AWQUA/improved-handheld-turbidimeter/version_A/hardware/stencil_files/main_board_v2.pdf

main_board_v2 (Visible layers) Scale=1.00 Wed Jul 12 17:47:27 2017

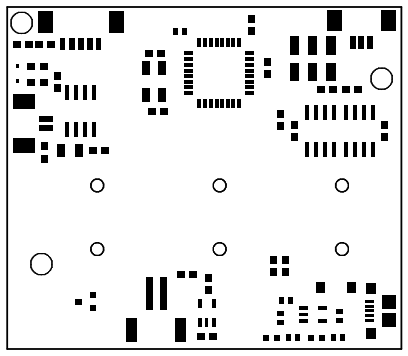
[picture p1: figure]
