AWQUA/improved-handheld-turbidimeter/version_A/testing/iht_A_dual_led_temperature_adjustment_20170707.xlsx

Sheet: Sheet1
0 | 5 | 8005.8 | 62.55
0 | 5 | 8005.11 | 62.54
0 | 5 | 8004.82 | 62.54
0 | 5 | 8005.34 | 62.54
0 | 5 | 8005.04 | 62.54
0 | 5 | 8004.91 | 62.54 |  | f | 5562.984315
0 | 5 | 8005.07 | 62.54
0 | 5 | 8004.42 | 62.54
0 | 5 | 8004.34 | 62.54 |  | Cp | 7.2e-10
0 | 5 | 8004.82 | 62.54 |  | GBW | 14000
0 | 5 | 8004.01 | 62.53 |  | Rl | 100000
0 | 5 | 8004.3 | 62.54
0 | 5 | 8004.87 | 62.54
0 | 5 | 8005.09 | 62.54
0.00 | 5 | 8005.16 | 62.54 |  |  |  |  |  | 20479.375
0.00 | 5 | 8004.77 | 62.54
0.00 | 5 | 8005.56 | 62.55
0.00 | 5 | 8005.59 | 62.55 |  | 0.256 | 7.812738426e-06 | 0.007812738426 | 251.1795404 | 320 | 68.82045961
0.00 | 5 | 8005.53 | 62.55 |  | 0.512 | 1.562547685e-05 | 0.01562547685
0.00 | 5 | 8006.06 | 62.55 |  | 1.024 | 3.12509537e-05 | 0.0312509537
0.00 | 5 | 8005.99 | 62.55 |  | 2.048 | 6.250190741e-05 | 0.06250190741
0.00 | 5 | 8005.75 | 62.55 |  | 4.096 | 0.0001250038148 | 0.1250038148
 |  |  |  |  | 6.144 | 0.0001875057222 | 0.1875057222
 |  |  |  | 1024 | 0 | 2152 | 67.25205237 | 54
 |  |  |  |  | 10 | 3446 | 107.6907865 | 80 | 129.4
 |  |  |  |  | 20 | 5162 | 161.317423 | 106 | 171.6
 |  |  |  |  | 30 | 7040 | 220.0067141 | 136 | 187.8
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
