AWQUA/improved-handheld-turbidimeter/version_A/hardware/images/hardware_flowchart.pdf

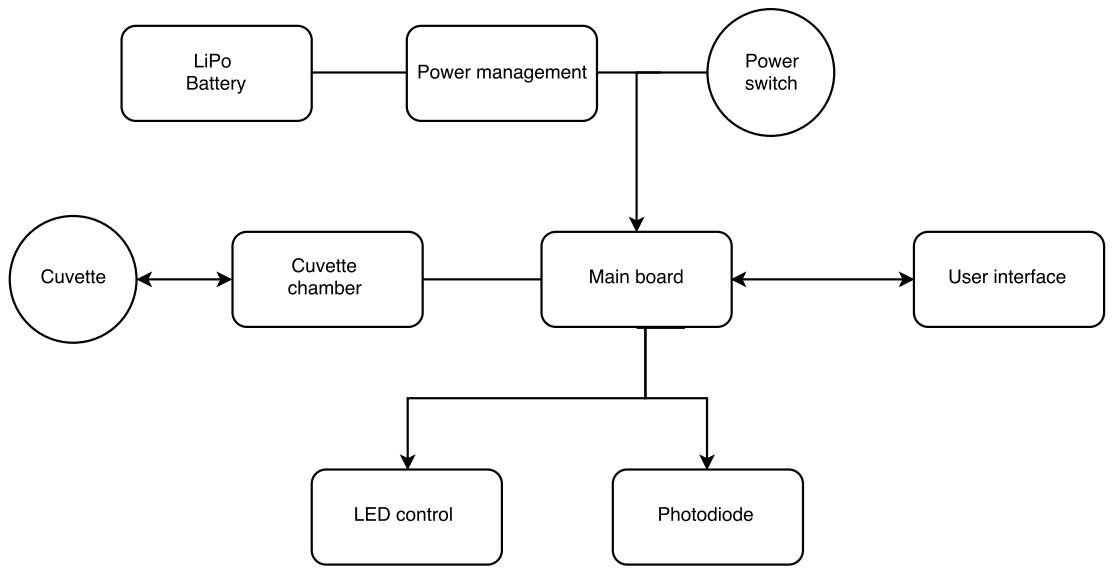
[picture p2: page 1]
