AWQUA/improved-handheld-turbidimeter/version_C/hardware/max30105.brd

## EAGLE design version_C/hardware/max30105.brd (2018-06-20)

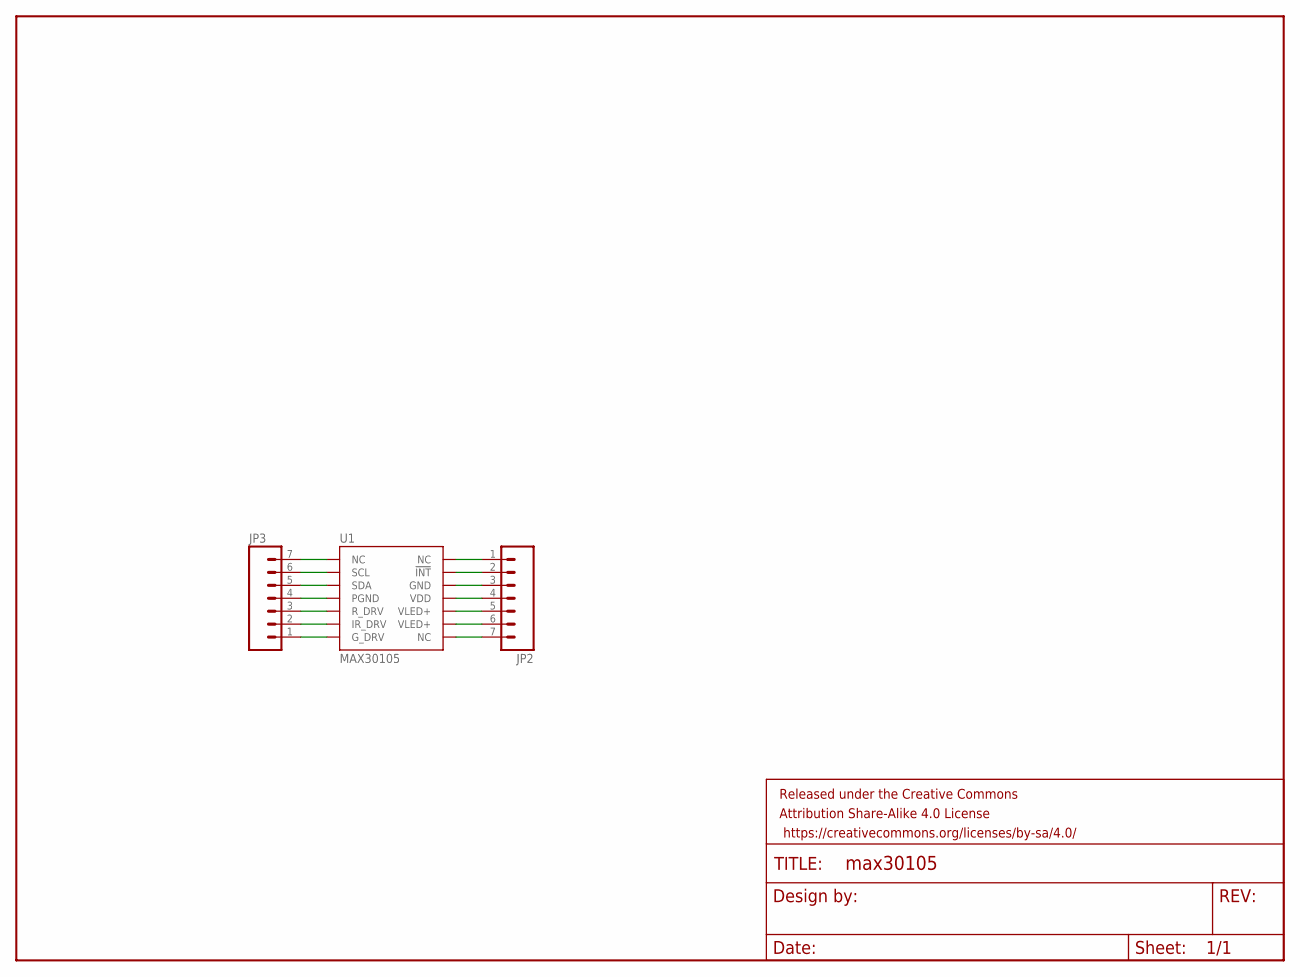
[picture p3: schematic max30105.sch]

Parts:
FRAME1: FRAME-LETTER; CREATIVE_COMMONS
JP2, JP3: M07; 1X07
U1: MAX30105; OLGA-14

Connections:
unnamed: JP2.1, U1.14 (NC)
unnamed: JP2.2, U1.13 (!INT)
unnamed: JP2.3, U1.12 (GND)
unnamed: JP2.4, U1.11 (VDD)
unnamed: JP2.5, U1.10 (VLED+)
unnamed: JP2.6, U1.9 (VLED+)
unnamed: JP2.7, U1.8 (NC)
unnamed: JP3.1, U1.7 (G_DRV)
unnamed: JP3.2, U1.6 (IR_DRV)
unnamed: JP3.3, U1.5 (R_DRV)
unnamed: JP3.4, U1.4 (PGND)
unnamed: JP3.5, U1.3 (SDA)
unnamed: JP3.6, U1.2 (SCL)
unnamed: JP3.7, U1.1 (NC)

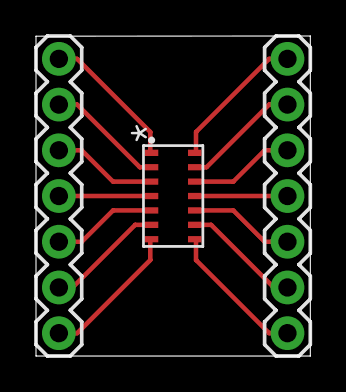
[picture p4: board max30105.brd from above]

Board: 2 copper layers, 15.2 x 17.8 mm, 4 parts (0 on the bottom side), 14 nets.
