AWQUA/improved-handheld-turbidimeter/version_C/hardware/max30105_breakout_iiT.brd

## EAGLE design version_C/hardware/max30105_breakout_iiT.brd (2018-06-20)

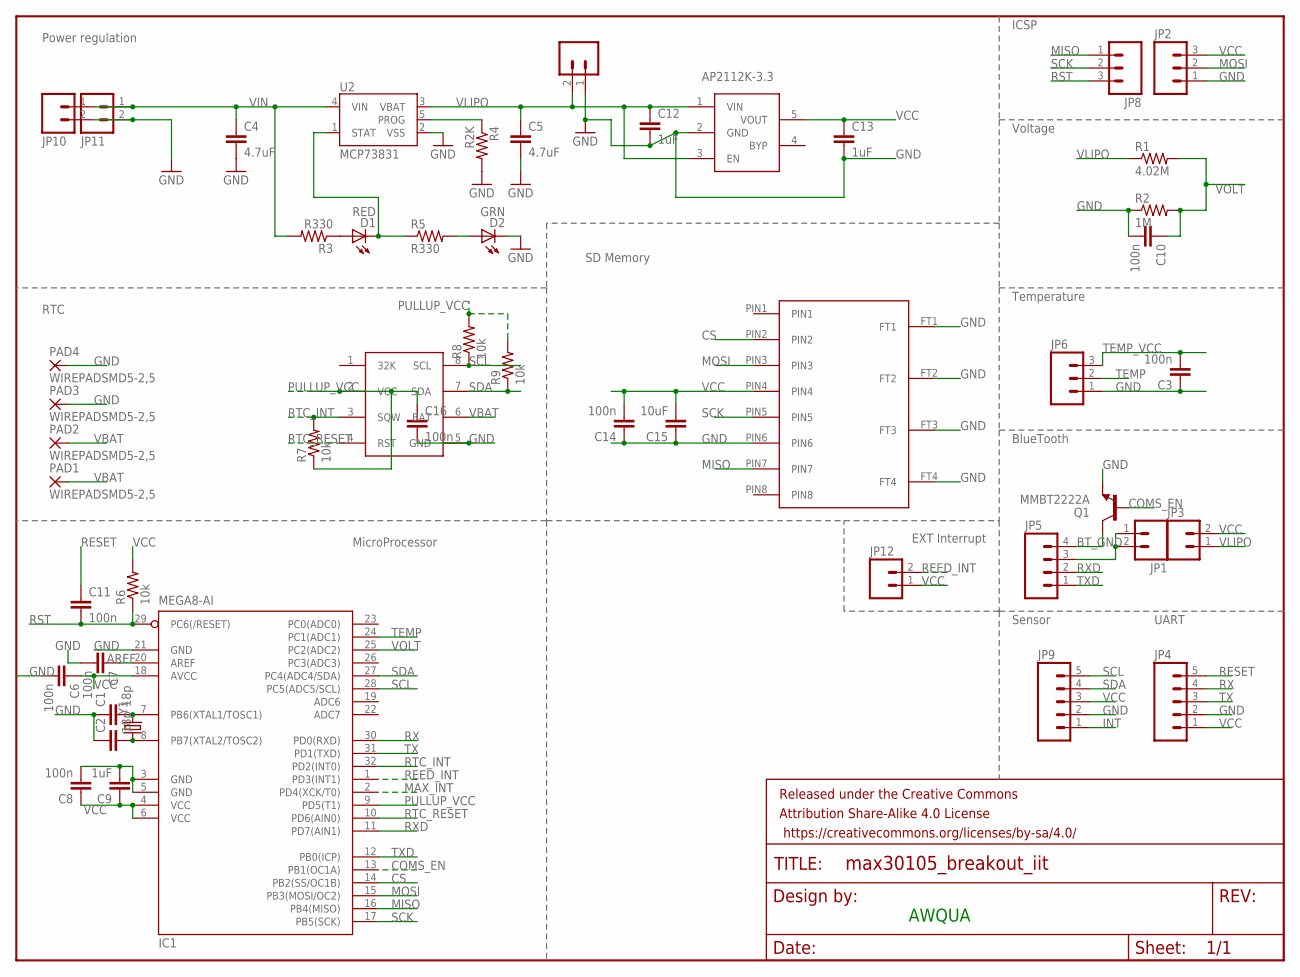
[picture p5: schematic max30105_breakout_iiT.sch]

Parts:
*RTC: DS3231M
C1, C2: 18p; 0603-CAP
C3, C6, C7, C8, C10, C11, C14, C16: 100n; 0603-CAP
C4, C5: 4.7uF; 0603-CAP
C9, C12, C13: 1uF; 0603-CAP
C15: 10uF; 0603-CAP
D1: RED; LED-0603
D2: GRN; LED-0603
FRAME1: FRAME-LETTER; CREATIVE_COMMONS
IC1: MEGA8-AI; TQFP32-08
JP1, JP3, JP10, JP11, JP12: M02PTH; 1X02
JP2, JP6, JP8: M03PTH; 1X03
JP4, JP9: M05PTH; 1X05
JP5: M04PTH; 1X04
JP7: LiPo Battery; JST-2-SMD
MICRO-SD: MICROSD-1010030368
PAD1, PAD2, PAD3, PAD4: WIREPADSMD5-2,5; 5-2,5
Q1: MMBT2222A; SOT23-3
R1: 4.02M; 0603-RES
R2: 1M; 0603-RES
R3, R5: R330; 0603-RES
R4: R2K; 0603-RES
R6, R7, R8, R9: 10k; 0603-RES
U2: MCP73831; SOT23-5
U$6: AP2112K-3.3; LP2985
Y1: CRYSTAL5X3; CRYSTAL-SMD-5X3

Connections:
AREF: C7.1, IC1.20 (AREF)
BT_GND: JP5.4, Q1.3 (C)
COMS_EN: IC1.13 (PB1(OC1A)), Q1.1 (B)
CS: IC1.14 (PB2(SS/OC1B)), MICRO-SD.PIN2
GND: *RTC.5 (GND), C1.1, C2.1, C3.1, C4.2, C5.2, C6.2, C7.2, C8.2, C9.2, C10.2, C12.2, C13.2, C14.1, C15.1, C16.2, D2.C, IC1.3 (GND), IC1.5 (GND), IC1.21 (GND), JP2.1, JP4.2, JP6.1, JP7.1, JP9.2, JP10.2, JP11.2, MICRO-SD.FT1, MICRO-SD.FT2, MICRO-SD.FT3, MICRO-SD.FT4, MICRO-SD.PIN6, PAD3.1, PAD4.1, Q1.2 (E), R2.1, R4.2, U2.2 (VSS), U$6.2 (GND)
INT: JP9.1
MAX_INT: IC1.2 (PD4(XCK/T0))
MISO: IC1.16 (PB4(MISO)), JP8.1, MICRO-SD.PIN7
MOSI: IC1.15 (PB3(MOSI/OC2)), JP2.2, MICRO-SD.PIN3
unnamed: D1.A, R3.1
unnamed: JP1.1, JP1.2, JP5.3
unnamed: D2.A, R5.2
PROG: R4.1, U2.5 (PROG)
PULLUP_VCC: *RTC.2 (VCC), C16.1, IC1.9 (PD5(T1)), R7.1, R8.2, R9.2
Q1: C2.2, IC1.8 (PB7(XTAL2/TOSC2)), Y1.1
Q2: C1.2, IC1.7 (PB6(XTAL1/TOSC1)), Y1.3 (2)
REED_INT: IC1.1 (PD3(INT1)), JP12.2
RESET: C11.1, JP4.5
RST: C11.2, IC1.29 (PC6(/RESET)), JP8.3, R6.1
RTC_INT: *RTC.3 (SQW), IC1.32 (PD2(INT0)), R7.2
RTC_RESET: *RTC.4 (RST), IC1.10 (PD6(AIN0))
RX: IC1.30 (PD0(RXD)), JP4.4
RXD: IC1.11 (PD7(AIN1)), JP5.2
SCK: IC1.17 (PB5(SCK)), JP8.2, MICRO-SD.PIN5
SCL: *RTC.8 (SCL), IC1.28 (PC5(ADC5/SCL)), JP9.5, R8.1
SDA: *RTC.7 (SDA), IC1.27 (PC4(ADC4/SDA)), JP9.4, R9.1
STAT: D1.C, R5.1, U2.1 (STAT)
TEMP: IC1.24 (PC1(ADC1)), JP6.2
TEMP_VCC: C3.2, JP6.3
TX: IC1.31 (PD1(TXD)), JP4.3
TXD: IC1.12 (PB0(ICP)), JP5.1
VBAT: *RTC.6 (BAT), PAD1.1, PAD2.1
VCC: C6.1, C8.1, C9.1, C13.1, C14.2, C15.2, IC1.4 (VCC), IC1.6 (VCC), IC1.18 (AVCC), JP2.3, JP3.2, JP4.1, JP9.3, JP12.1, MICRO-SD.PIN4, R6.2, U$6.5 (VOUT)
VIN: C4.1, JP10.1, JP11.1, R3.2, U2.4 (VIN)
VLIPO: C5.1, C12.1, JP3.1, JP7.2, R1.1, U2.3 (VBAT), U$6.1 (VIN), U$6.3 (EN)
VOLT: C10.1, IC1.25 (PC2(ADC2)), R1.2, R2.2

Notes on the sheet:
AWQUA
Temperature
UART
ICSP
Voltage
BlueTooth
Sensor
Power regulation
AP2112K-3.3
SD Memory
RTC
MicroProcessor
EXT Interrupt

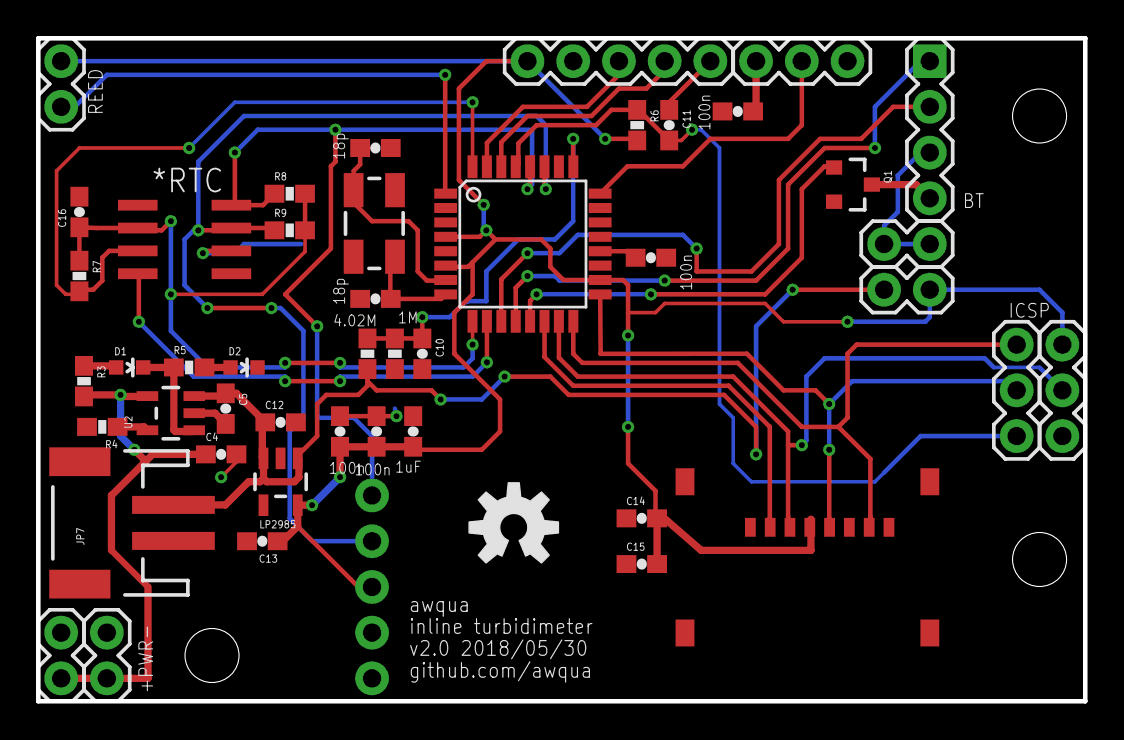
[picture p6: board max30105_breakout_iiT.brd from above]

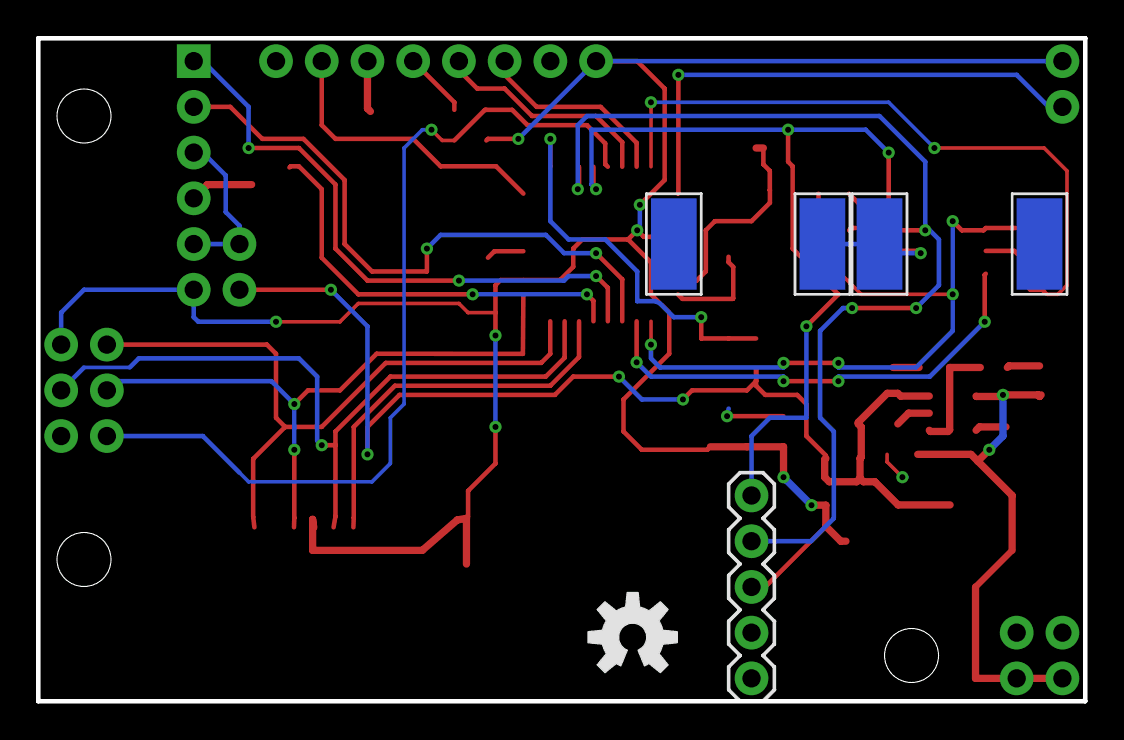
[picture p7: board max30105_breakout_iiT.brd from below]

Board: 2 copper layers, 58.2 x 36.8 mm, 53 parts (6 on the bottom side), 34 nets.

Other parts of the board:
U$1, U$4: OSHW-LOGO-M
