AWQUA/improved-handheld-turbidimeter/version_C/hardware/PCF2129.brd

## EAGLE design version_C/hardware/PCF2129.brd (2018-06-20)

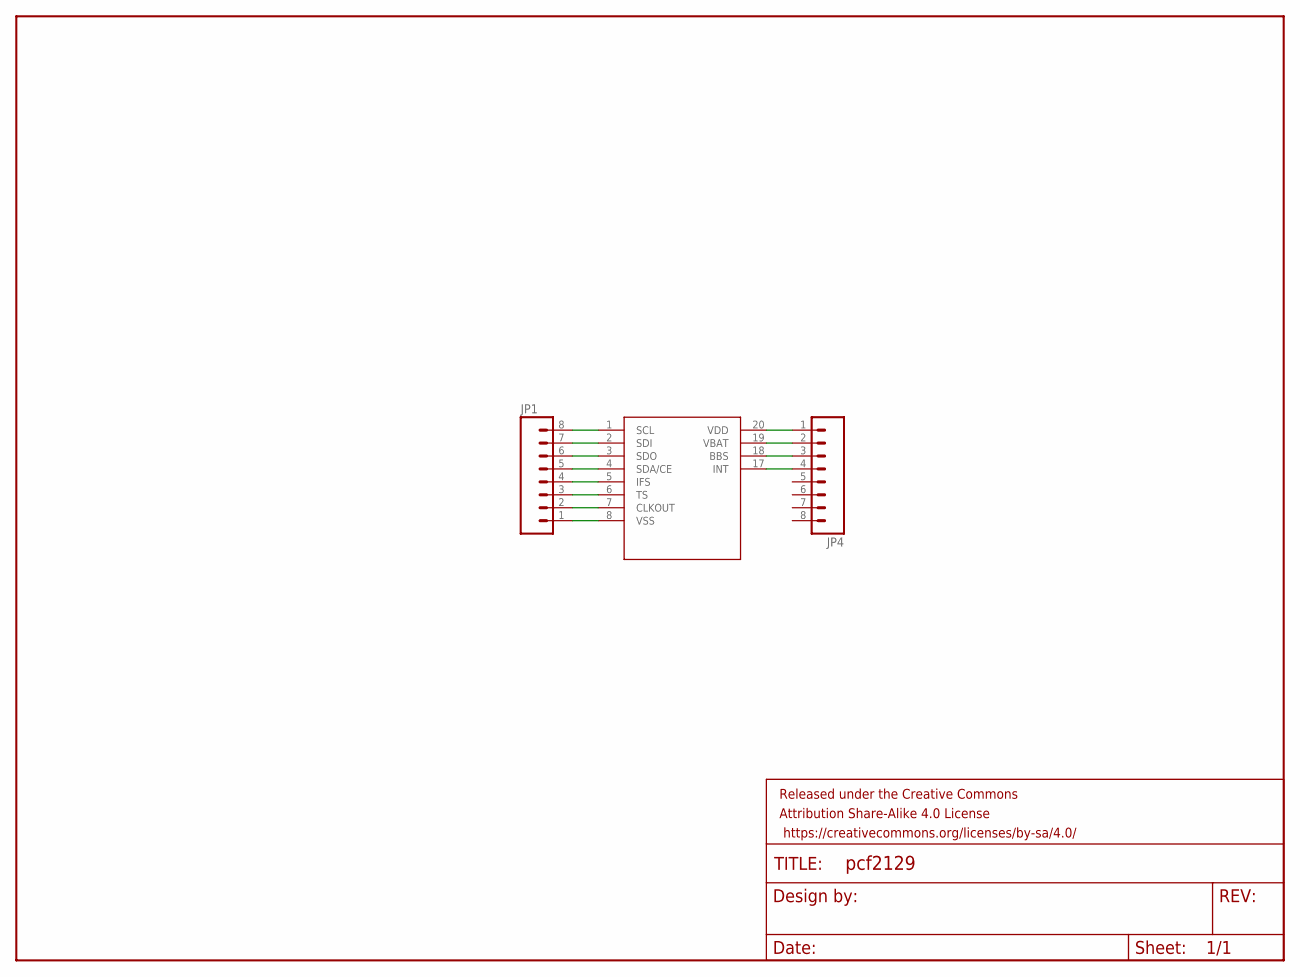
[picture p8: schematic PCF2129.sch]

Parts:
FRAME1: FRAME-LETTER; CREATIVE_COMMONS
JP1, JP4: M08SILK_FEMALE_PTH; 1X08
U$1: PCF2129

Connections:
unnamed: JP1.1, U$1.8 (VSS)
unnamed: JP1.2, U$1.7 (CLKOUT)
unnamed: JP1.3, U$1.6 (TS)
unnamed: JP1.4, U$1.5 (IFS)
unnamed: JP1.5, U$1.4 (SDA/CE)
unnamed: JP1.6, U$1.3 (SDO)
unnamed: JP1.7, U$1.2 (SDI)
unnamed: JP1.8, U$1.1 (SCL)
unnamed: JP4.1, U$1.20 (VDD)
unnamed: JP4.2, U$1.19 (VBAT)
unnamed: JP4.3, U$1.18 (BBS)
unnamed: JP4.4, U$1.17 (INT)

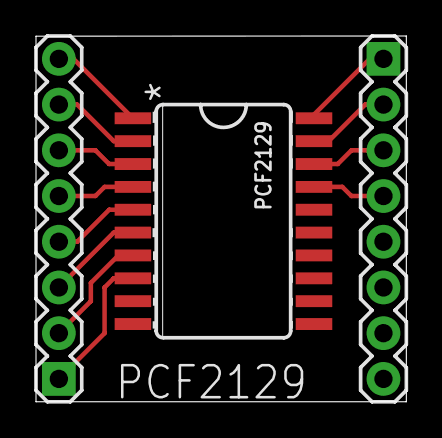
[picture p9: board PCF2129.brd from above]

Board: 2 copper layers, 20.6 x 20.3 mm, 4 parts (0 on the bottom side), 12 nets.
