AWQUA/improved-handheld-turbidimeter/version_B/hardware/light_emitter.brd

## EAGLE design version_B/hardware/light_emitter.brd (2017-10-30, an earlier design)

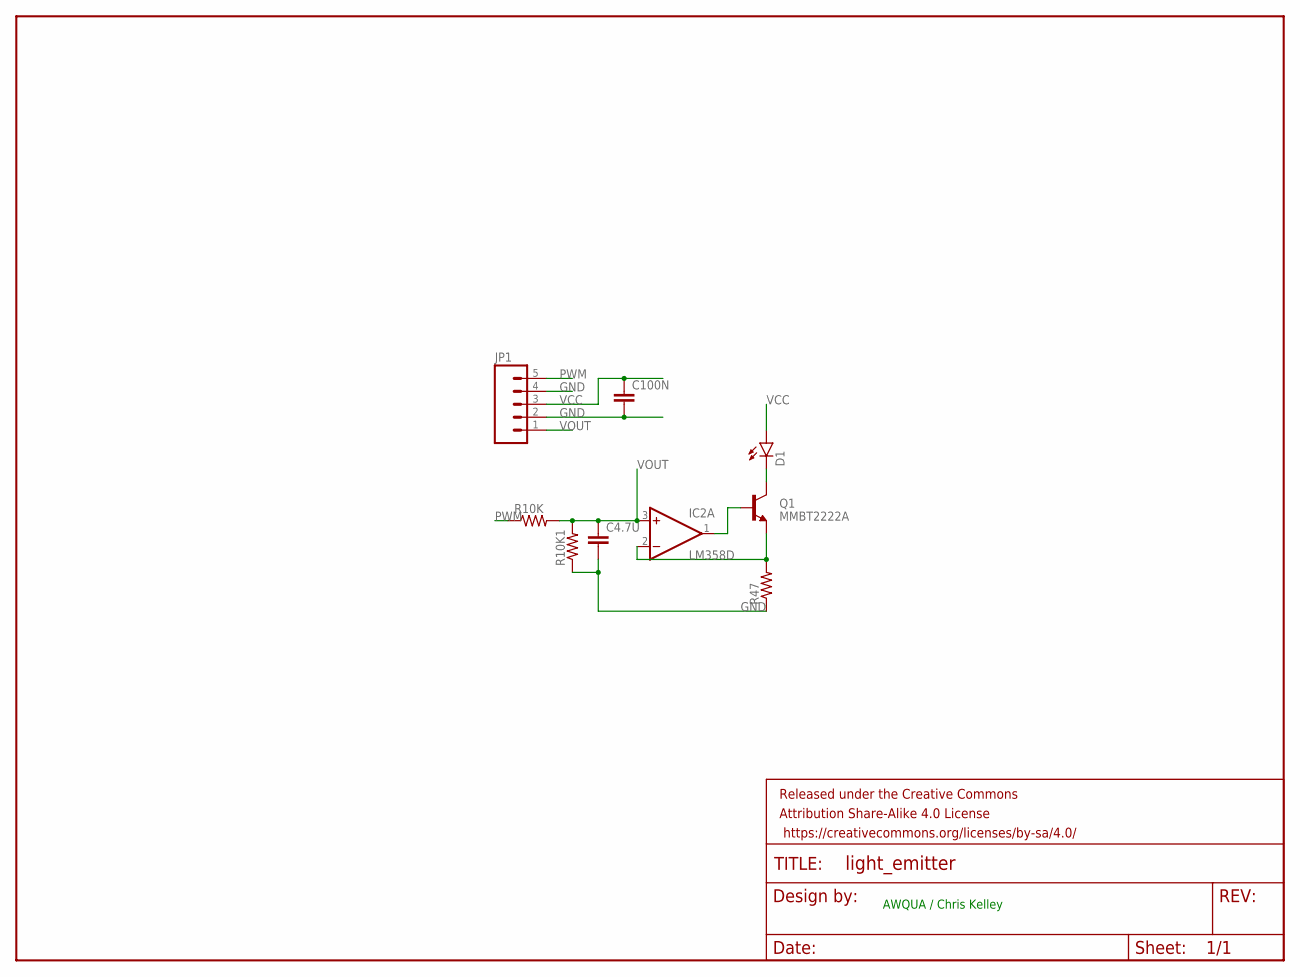
[picture p12: schematic light_emitter.sch]

Parts:
C4.7U, C100N: CAP0603-CAP; 0603-CAP
D1: LED5MM
FRAME1: FRAME-LETTER; CREATIVE_COMMONS
IC2: LM358D; SO08
JP1: M05PTH; 1X05
Q1: MMBT2222A; SOT23-3
R10K, R10K1, R47: RESISTOR0603-RES; 0603-RES

Connections:
GND: C4.7U.2, C100N.2, JP1.2, JP1.4, R10K1.1, R47.1
unnamed: IC2.2 (-IN), Q1.2 (E), R47.2
unnamed: IC2.1 (OUT), Q1.1 (B)
unnamed: D1.K (C), Q1.3 (C)
PWM: JP1.5, R10K.1
V+: IC2.8 (V+)
V-: IC2.4 (V-)
VCC: C100N.1, D1.A, JP1.3
VOUT: C4.7U.1, IC2.3 (+IN), JP1.1, R10K.2, R10K1.2

Notes on the sheet:
AWQUA / Chris Kelley

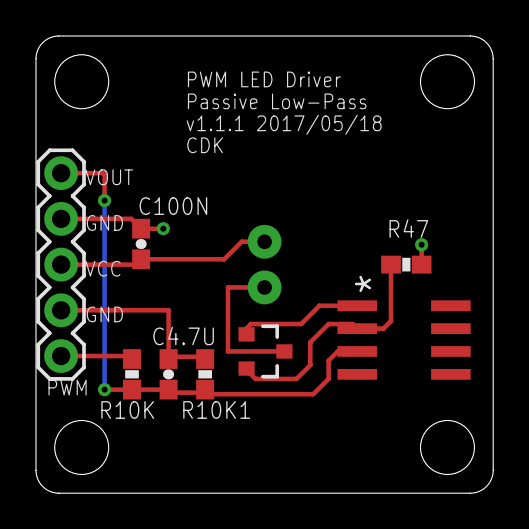
[picture p13: board version_B/hardware/light_emitter.brd from above]

Board: 2 copper layers, 25.4 x 25.4 mm, 10 parts (1 on the bottom side), 7 nets.
