AWQUA/improved-handheld-turbidimeter/version_B/hardware/light_detector.brd

## EAGLE design version_B/hardware/light_detector.brd (2017-10-30, an earlier design)

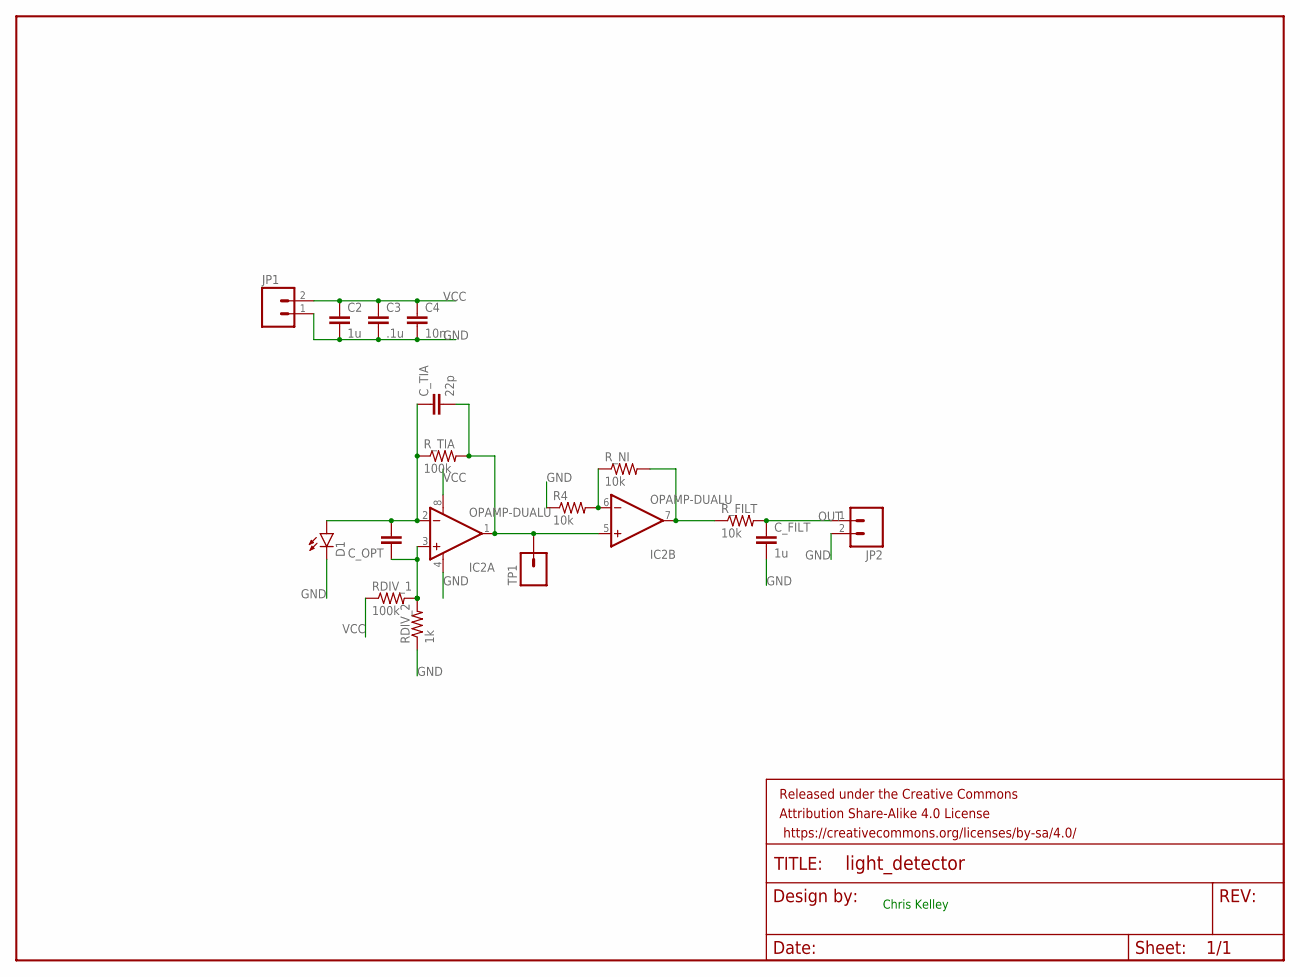
[picture p14: schematic light_detector.sch]

Parts:
C2: 1u; 0805
C3: .1u; 0805
C4: 10n; 0805
C_FILT: 1u; 0805
C_OPT: CAP0805; 0805
C_TIA: 22p; 0805
D1: LED5MM
FRAME1: FRAME-LETTER; CREATIVE_COMMONS
IC2: OPAMP-DUALU; SO08
JP1, JP2: M02PTH; 1X02
R4: 10k; 0603-RES
RDIV_1: 100k; 0603-RES
RDIV_2: 1k; 0603-RES
R_FILT: 10k; 0603-RES
R_NI: 10k; 0603-RES
R_TIA: 100k; 0603-RES
TP1: M01PTH; 1X01

Connections:
GND: C2.2, C3.2, C4.2, C_FILT.2, D1.K (C), IC2.4 (V-), JP1.1, JP2.2, R4.1, RDIV_2.1
unnamed: C_OPT.2, C_TIA.1, D1.A, IC2.2 (-IN), R_TIA.1
unnamed: C_TIA.2, IC2.1 (OUT), IC2.5 (+IN), R_TIA.2, TP1.1
unnamed: C_OPT.1, IC2.3 (+IN), RDIV_1.2, RDIV_2.2
unnamed: IC2.7 (OUT), R_FILT.1, R_NI.2
unnamed: IC2.6 (-IN), R4.2, R_NI.1
OUT: C_FILT.1, JP2.1, R_FILT.2
VCC: C2.1, C3.1, C4.1, IC2.8 (V+), JP1.2, RDIV_1.1

Notes on the sheet:
Chris Kelley

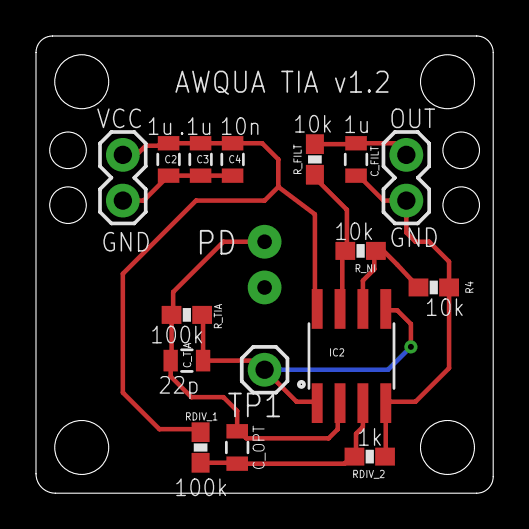
[picture p15: board light_detector.brd from above]

Board: 2 copper layers, 25.4 x 25.4 mm, 18 parts (1 on the bottom side), 8 nets.
