AWQUA/improved-handheld-turbidimeter/version_B/hardware/main_board__PT.brd

## EAGLE design version_B/hardware/main_board__PT.brd (2017-10-30, an earlier design)

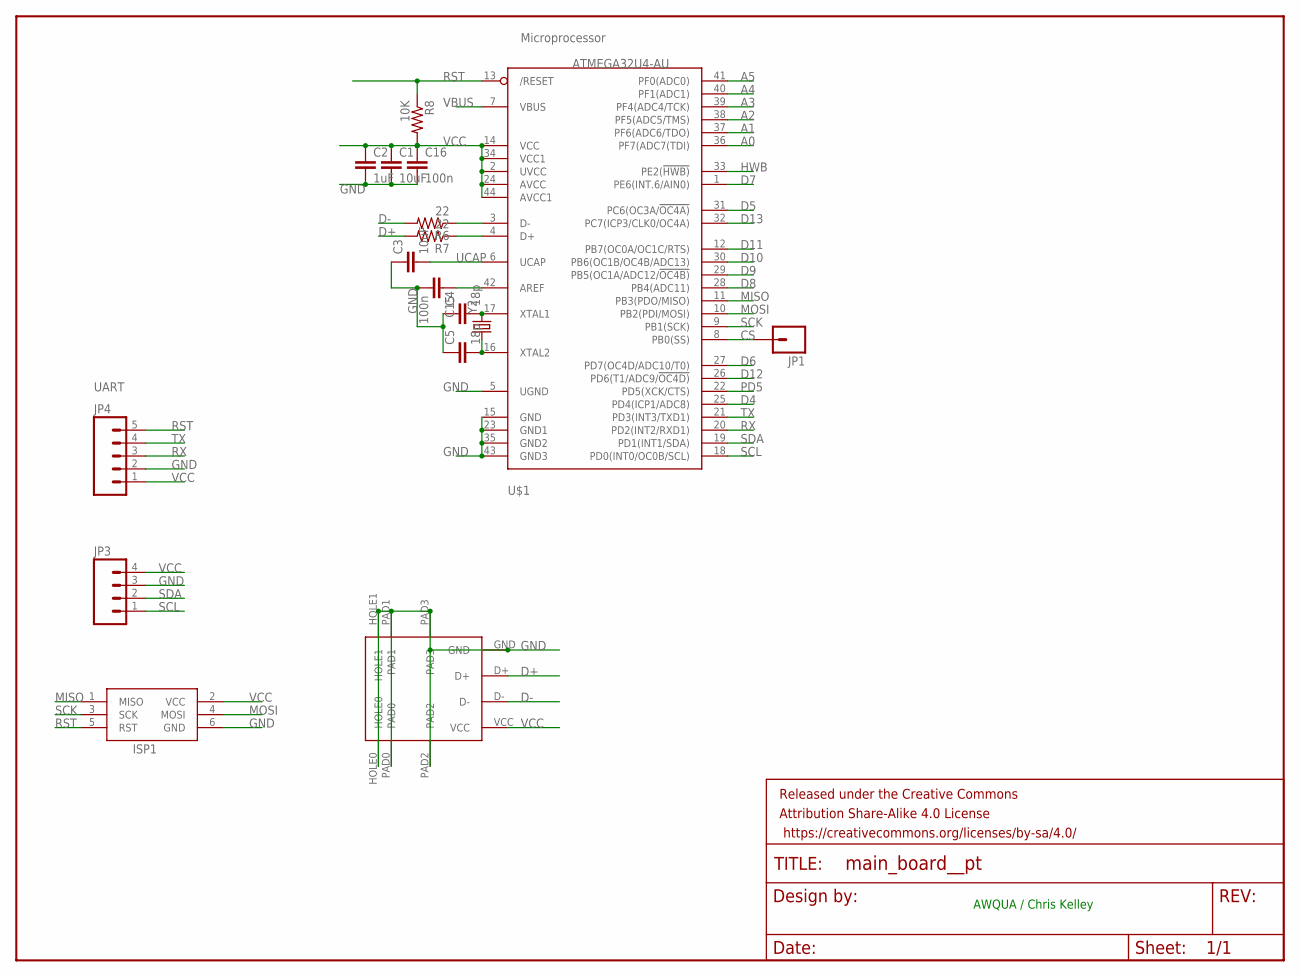
[picture p16: schematic main_board__PT.sch]

Parts:
C1, C3: 10uF; 0603-CAP
C2: 1uF; 0603-CAP
C4, C5: 18p; 0603-CAP
C15, C16: 100n; 0603-CAP
FRAME2: FRAME-LETTER; CREATIVE_COMMONS
ISP1: AVRISP-6; AVRISP
JP1: M01PTH; 1X01
JP3: M04PTH; 1X04
JP4: M05PTH; 1X05
R6, R7: 22; 0603-RES
R8: 10K; 1/6W-RES
U$1: ATMEGA32U4-AU; TQFP44
U$2: USBMICRO-10118193-0001LF
Y2: CRYSTAL5X3; CRYSTAL-SMD-5X3

Connections:
A0: U$1.36 (PF7(ADC7(TDI))
A1: U$1.37 (PF6(ADC6/TDO))
A2: U$1.38 (PF5(ADC5/TMS))
A3: U$1.39 (PF4(ADC4/TCK))
A4: U$1.40 (PF1(ADC1))
A5: U$1.41 (PF0(ADC0))
CS: JP1.1, U$1.8 (PB0(SS))
D4: U$1.25 (PD4(ICP1/ADC8))
D5: U$1.31 (PC6(OC3A/!OC4A))
D6: U$1.27 (PD7(OC4D/ADC10/T0))
D7: U$1.1 (PE6(INT.6/AIN0))
D8: U$1.28 (PB4(ADC11))
D9: U$1.29 (PB5(OC1A/ADC12/!OC4B))
D10: U$1.30 (PB6(OC1B/OC4B/ADC13))
D11: U$1.12 (PB7(OC0A/OC1C/RTS))
D12: U$1.26 (PD6(T1/ADC9/!OC4D))
D13: U$1.32 (PC7(ICP3/CLK0/OC4A))
D+: R7.2, U$2.D+
D-: R6.2, U$2.D-
GND: C1.2, C2.2, C3.1, C4.1, C5.1, C15.2, C16.2, ISP1.6 (GND), JP3.3, JP4.2, U$1.5 (UGND), U$1.15 (GND), U$1.23 (GND1), U$1.35 (GND2), U$1.43 (GND3), U$2.GND, U$2.HOLE0, U$2.HOLE1, U$2.PAD0, U$2.PAD1, U$2.PAD2, U$2.PAD3
HWB: U$1.33 (PE2(!HWB))
MISO: ISP1.1 (MISO), U$1.11 (PB3(PDO/MISO))
MOSI: ISP1.4 (MOSI), U$1.10 (PB2(PDI/MOSI))
unnamed: R6.1, U$1.3 (D-)
unnamed: R7.1, U$1.4 (D+)
unnamed: C15.1, U$1.42 (AREF)
unnamed: C4.2, U$1.17 (XTAL1), Y2.3 (2)
unnamed: C5.2, U$1.16 (XTAL2), Y2.1
PD5: U$1.22 (PD5(XCK/CTS))
RST: ISP1.5 (RST), JP4.5, R8.1, U$1.13 (/RESET)
RX: JP4.3, U$1.20 (PD2(INT2/RXD1))
SCK: ISP1.3 (SCK), U$1.9 (PB1(SCK))
SCL: JP3.1, U$1.18 (PD0(INT0/OC0B/SCL))
SDA: JP3.2, U$1.19 (PD1(INT1/SDA))
TX: JP4.4, U$1.21 (PD3(INT3/TXD1))
UCAP: C3.2, U$1.6 (UCAP)
VBUS: U$1.7 (VBUS)
VCC: C1.1, C2.1, C16.1, ISP1.2 (VCC), JP3.4, JP4.1, R8.2, U$1.2 (UVCC), U$1.14 (VCC), U$1.24 (AVCC), U$1.34 (VCC1), U$1.44 (AVCC1), U$2.VCC

Notes on the sheet:
UART
Microprocessor
AWQUA / Chris Kelley

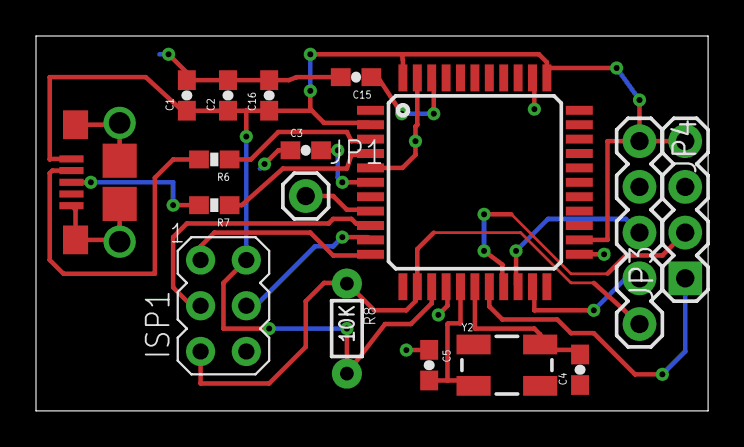
[picture p17: board main_board__PT.brd from above]

Board: 2 copper layers, 37.3 x 20.8 mm, 18 parts (0 on the bottom side), 19 nets.
