AWQUA/improved-handheld-turbidimeter/planning/hardware/BT_magnetic_switch.brd

## EAGLE design planning/hardware/BT_magnetic_switch.brd (2017-10-30)

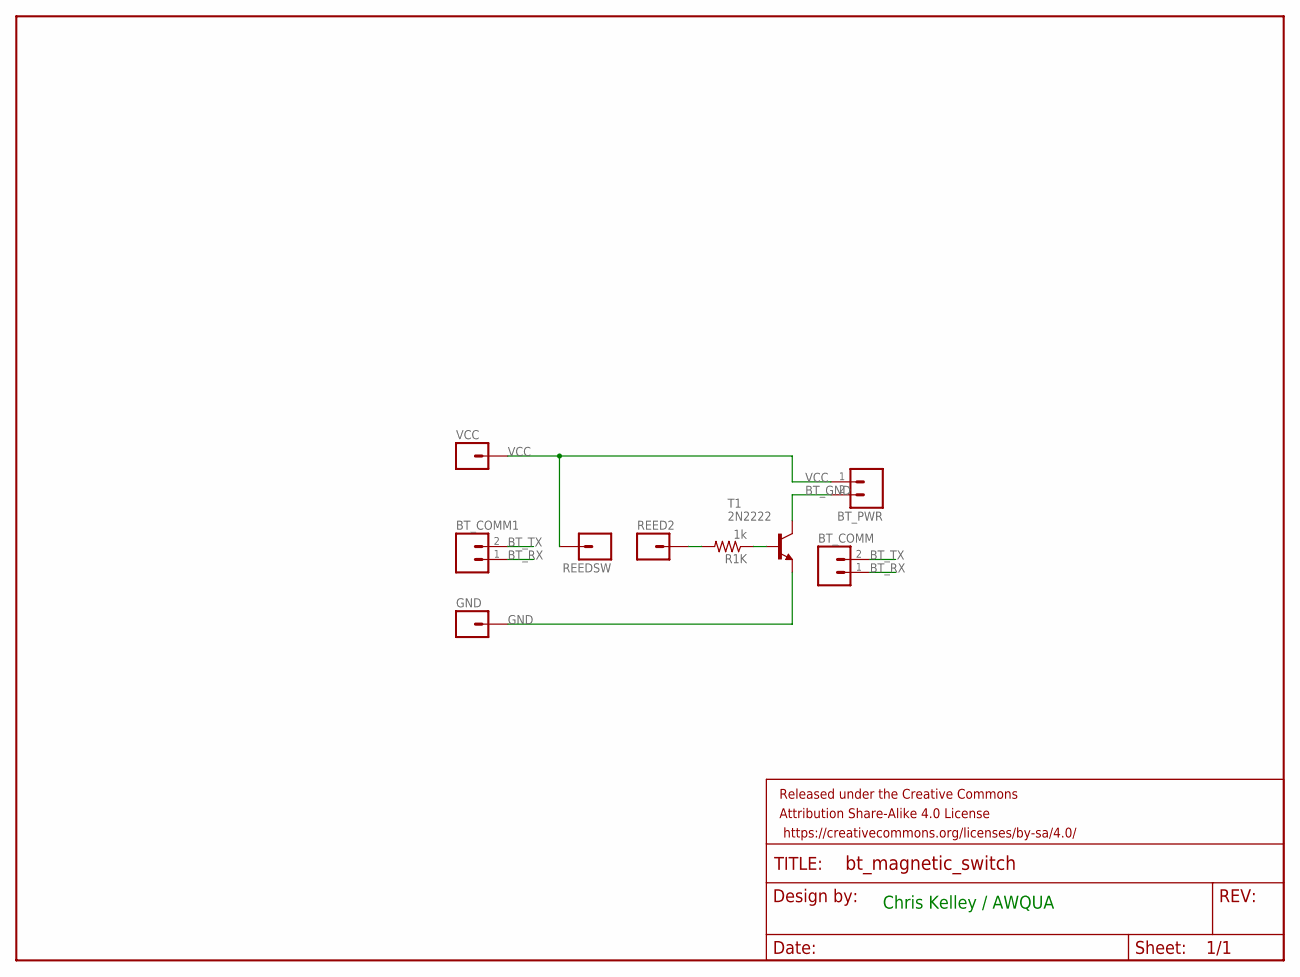
[picture p18: schematic BT_magnetic_switch.sch]

Parts:
BT_COMM, BT_COMM1: M02PTH; 1X02
BT_PWR: M02PTH; 1X02
FRAME1: FRAME-LETTER; CREATIVE_COMMONS
GND: M01PTH; 1X01
R1K: 1k; 0603-RES
REED2: M01PTH; 1X01
REEDSW: M01PTH; 1X01
T1: 2N2222; TO92-EBC-OVAL
VCC: M01PTH; 1X01

Connections:
BT_GND: BT_PWR.2, T1.C
BT_RX: BT_COMM.1, BT_COMM1.1
BT_TX: BT_COMM.2, BT_COMM1.2
GND: GND.1, T1.E
unnamed: R1K.1, T1.B
unnamed: R1K.2, REED2.1
VCC: BT_PWR.1, REEDSW.1, VCC.1

Notes on the sheet:
Chris Kelley / AWQUA

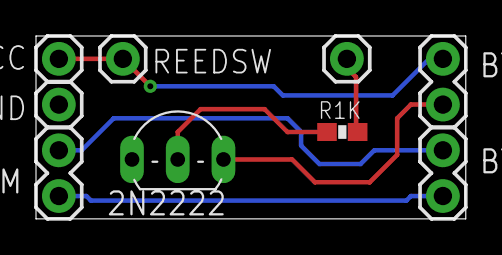
[picture p19: board BT_magnetic_switch.brd from above]

Board: 2 copper layers, 23.9 x 10.2 mm, 10 parts (0 on the bottom side), 7 nets.
