AWQUA/improved-handheld-turbidimeter/version_A/hardware/light_emitter.brd

## EAGLE design version_A/hardware/light_emitter.brd (2017-10-30, an earlier design)

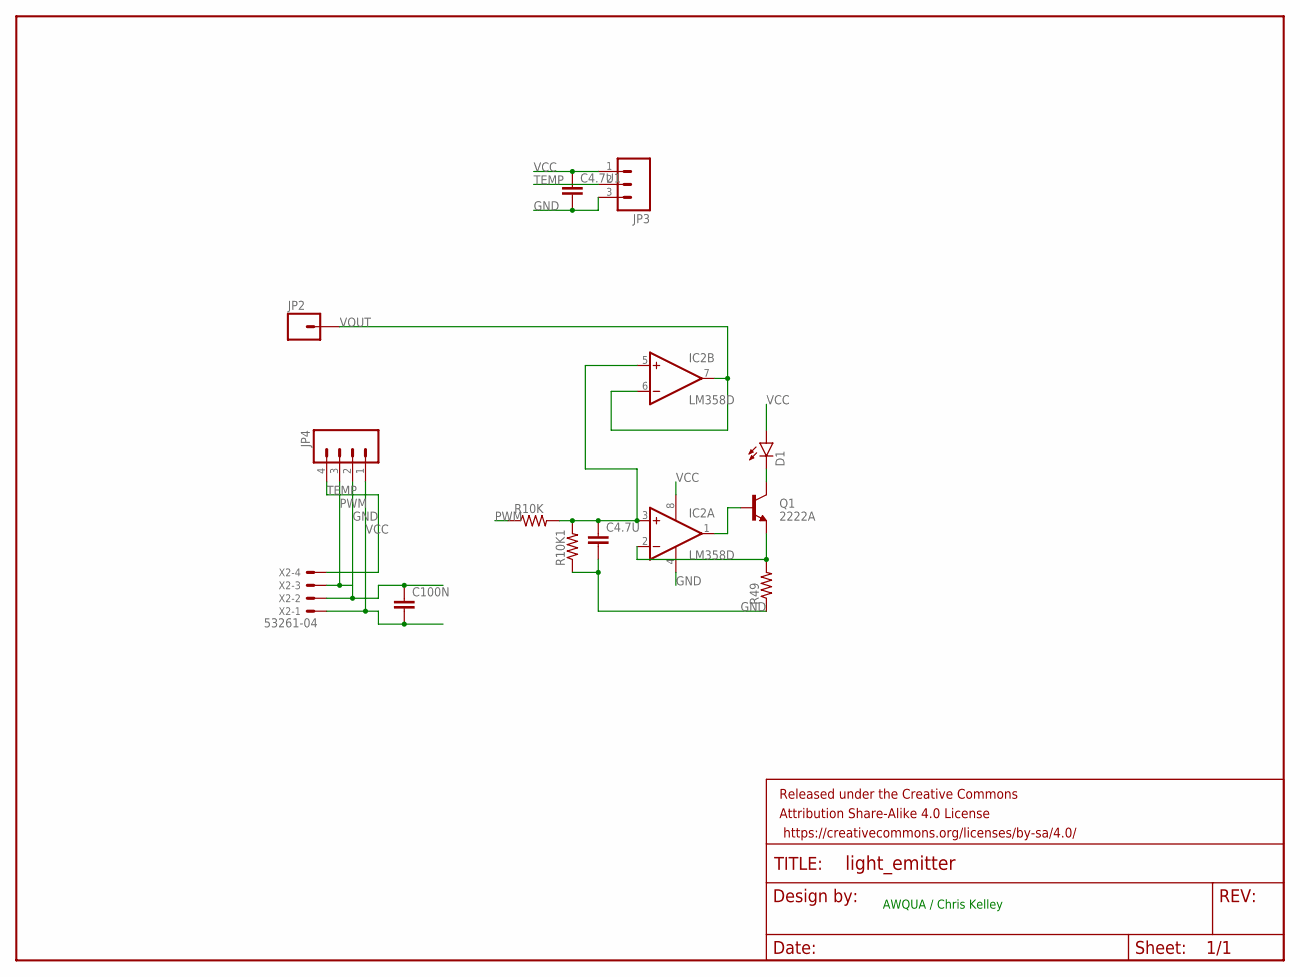
[picture p20: schematic light_emitter.sch]

Parts:
C4.7U, C4.7U1, C100N: CAP0603-CAP; 0603-CAP
D1: LED5MM
FRAME1: FRAME-LETTER; CREATIVE_COMMONS
IC2: LM358D; SO08
JP2: M01PTH; 1X01
JP3: M03PTH; 1X03
JP4: M04PTH; 1X04
Q1: 2222A; SOT23-3
R10K, R10K1, R49: RESISTOR0603-RES; 0603-RES
X2: 53261-04

Connections:
GND: C4.7U.2, C4.7U1.2, C100N.1, IC2.4 (V-), JP3.3, JP4.2, R10K1.1, R49.1, X2.2
unnamed: IC2.2 (-IN), Q1.2 (E), R49.2
unnamed: IC2.1 (OUT), Q1.1 (B)
unnamed: D1.K (C), Q1.3 (C)
PWM: JP4.3, R10K.1, X2.3
TEMP: JP3.2, JP4.4, X2.4
VCC: C4.7U1.1, C100N.2, D1.A, IC2.8 (V+), JP3.1, JP4.1, X2.1
VOUT: IC2.6 (-IN), IC2.7 (OUT), JP2.1
VOUT_PREBUF: C4.7U.1, IC2.3 (+IN), IC2.5 (+IN), R10K.2, R10K1.2

Notes on the sheet:
AWQUA / Chris Kelley

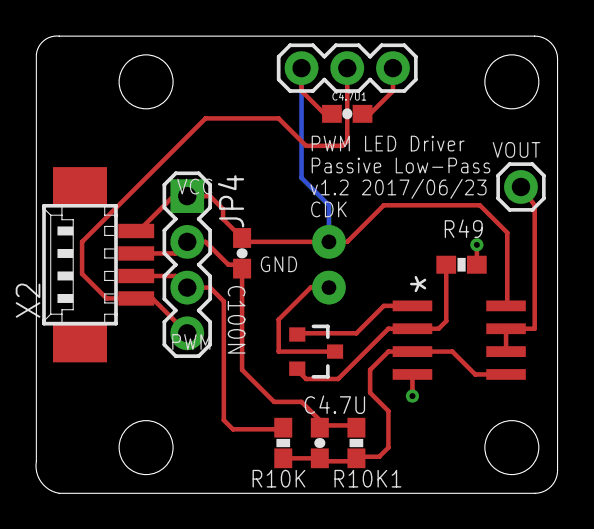
[picture p21: board version_A/hardware/light_emitter.brd from above]

Board: 2 copper layers, 29.0 x 25.4 mm, 14 parts (1 on the bottom side), 9 nets.
