AWQUA/improved-handheld-turbidimeter/version_A/hardware/main_board.brd

## EAGLE design version_A/hardware/main_board.brd (2017-10-30, an earlier design)

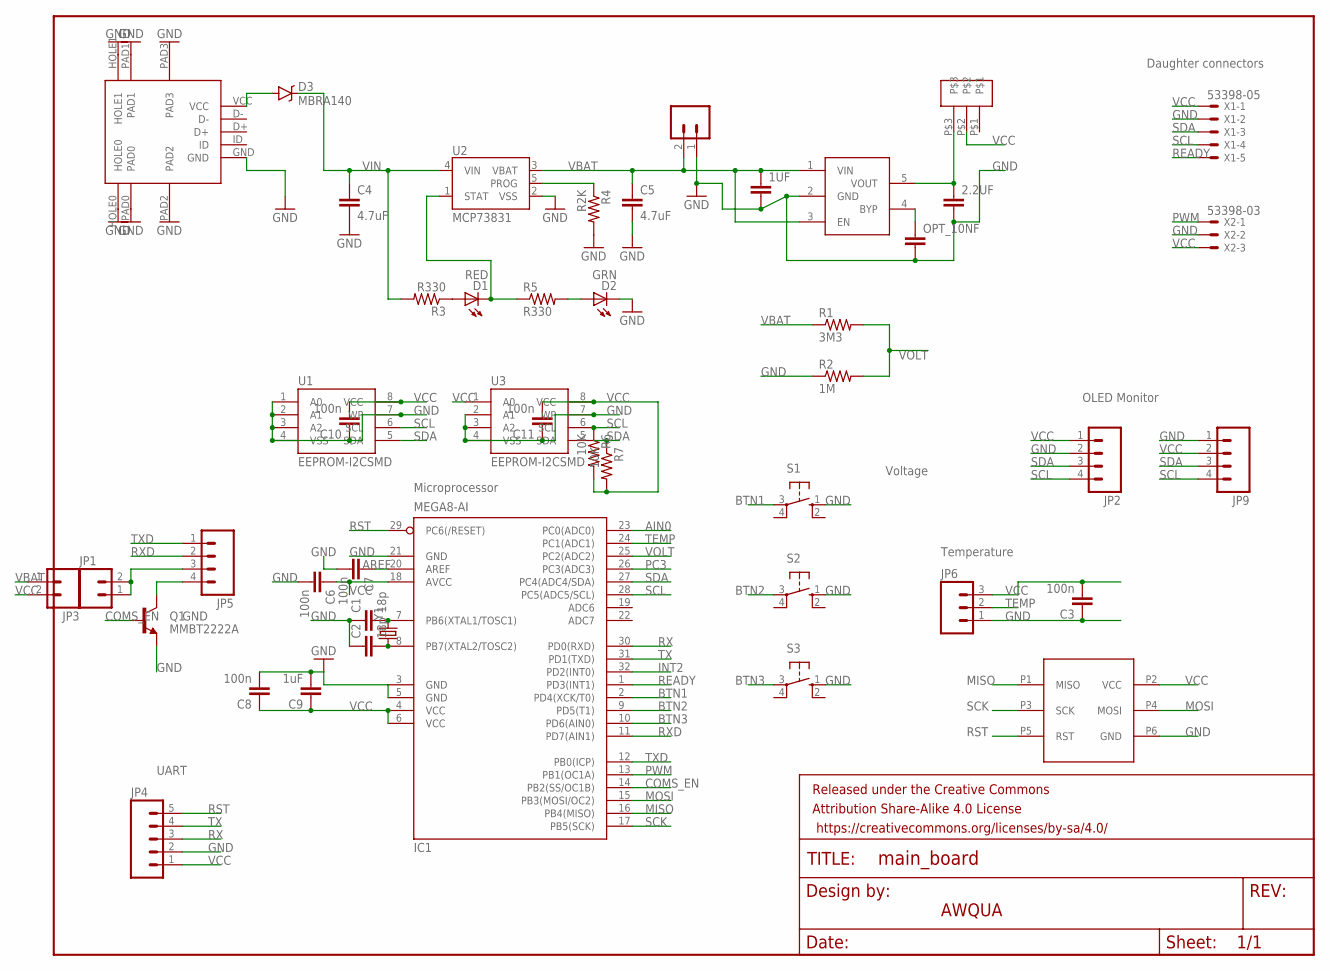
[picture p22: schematic main_board.sch]

Parts:
1UF, 2.2UF: CAP0603-CAP; 0603-CAP
C1, C2: 18p; 0603-CAP
C3, C6, C7, C8, C10, C11: 100n; 0603-CAP
C4, C5: 4.7uF; 0402-CAP
C9: 1uF; 0603-CAP
D1: RED; LED-0603
D2: GRN; LED-0603
D3: MBRA140; SMA-DIODE
FRAME1: FRAME-LETTER; CREATIVE_COMMONS
IC1: MEGA8-AI; TQFP32-08
JP1, JP3: M02PTH; 1X02
JP2, JP5, JP9: M04PTH; 1X04
JP4: M05PTH; 1X05
JP6: M03PTH; 1X03
JP7: LiPo Battery; JST-2-SMD
OPT_10NF: CAP0603-CAP; 0603-CAP
Q1: MMBT2222A; SOT23-3
R1: 3M3; 0603-RES
R2: 1M; 0603-RES
R3, R5: R330; 0402-RES
R4: R2K; 0402-RES
R6, R7: 10K; 0402-RES
S1, S2, S3: 40-XX; B3F-40XX
U1, U3: EEPROM-I2CSMD; SO08
U2: MCP73831; SOT23-5
U$1: ISP-SMD-6PIN
U$2: OS102-SPDT-SWITCH
U$3: USBMICRO-10118193-0001LF
U$6: LP2985
X1: 53398-05
X2: 53398-03
Y1: CRYSTAL5X3; CRYSTAL-SMD-5X3

Connections:
AIN0: IC1.23 (PC0(ADC0))
AREF: C7.1, IC1.20 (AREF)
BTN1: IC1.2 (PD4(XCK/T0)), S1.3
BTN2: IC1.9 (PD5(T1)), S2.3
BTN3: IC1.10 (PD6(AIN0)), S3.3
COMS_EN: IC1.14 (PB2(SS/OC1B)), Q1.1 (B)
GND: 1UF.2, 2.2UF.2, C1.1, C2.1, C3.1, C4.2, C5.2, C6.2, C7.2, C8.2, C9.2, C10.1, C11.1, D2.C, IC1.3 (GND), IC1.5 (GND), IC1.21 (GND), JP2.2, JP4.2, JP5.4, JP6.1, JP7.1, JP9.1, OPT_10NF.2, Q1.2 (E), Q1.3 (C), R2.1, R4.2, S1.1 (S), S2.1 (S), S3.1 (S), U1.1 (A0), U1.2 (A1), U1.3 (A2), U1.4 (VSS), U1.7 (WP), U2.2 (VSS), U3.2 (A1), U3.3 (A2), U3.4 (VSS), U3.7 (WP), U$1.P6 (GND), U$3.GND, U$3.HOLE0, U$3.HOLE1, U$3.PAD0, U$3.PAD1, U$3.PAD2, U$3.PAD3, U$6.2 (GND), X1.2, X2.2
INT2: IC1.32 (PD2(INT0))
MISO: IC1.16 (PB4(MISO)), U$1.P1 (MISO)
MOSI: IC1.15 (PB3(MOSI/OC2)), U$1.P4 (MOSI)
unnamed: D1.A, R3.1
unnamed: OPT_10NF.1, U$6.4 (BYP)
unnamed: JP1.1, JP1.2, JP5.3
unnamed: 2.2UF.1, U$2.P$3, U$6.5 (VOUT)
unnamed: D2.A, R5.2
PC3: IC1.26 (PC3(ADC3))
PROG: R4.1, U2.5 (PROG)
PWM: IC1.13 (PB1(OC1A)), X2.1
Q1: C2.2, IC1.8 (PB7(XTAL2/TOSC2)), Y1.1
Q2: C1.2, IC1.7 (PB6(XTAL1/TOSC1)), Y1.3 (2)
READY: IC1.1 (PD3(INT1)), X1.5
RST: IC1.29 (PC6(/RESET)), JP4.5, U$1.P5 (RST)
RX: IC1.30 (PD0(RXD)), JP4.3
RXD: IC1.11 (PD7(AIN1)), JP5.2
SCK: IC1.17 (PB5(SCK)), U$1.P3 (SCK)
SCL: IC1.28 (PC5(ADC5/SCL)), JP2.4, JP9.4, R6.1, U1.6 (SCL), U3.6 (SCL), X1.4
SDA: IC1.27 (PC4(ADC4/SDA)), JP2.3, JP9.3, R7.1, U1.5 (SDA), U3.5 (SDA), X1.3
STAT: D1.C, R5.1, U2.1 (STAT)
TEMP: IC1.24 (PC1(ADC1)), JP6.2
TX: IC1.31 (PD1(TXD)), JP4.4
TXD: IC1.12 (PB0(ICP)), JP5.1
VBAT: 1UF.1, C5.1, JP3.1, JP7.2, R1.1, U2.3 (VBAT), U$6.1 (VIN), U$6.3 (EN)
VBUS: D3.A, U$3.VCC
VCC: C3.2, C6.1, C8.1, C9.1, C10.2, C11.2, IC1.4 (VCC), IC1.6 (VCC), IC1.18 (AVCC), JP2.1, JP3.2, JP4.1, JP6.3, JP9.2, R6.2, R7.2, U1.8 (VCC), U3.1 (A0), U3.8 (VCC), U$1.P2 (VCC), U$2.P$2, X1.1, X2.3
VIN: C4.1, D3.C, R3.2, U2.4 (VIN)
VOLT: IC1.25 (PC2(ADC2)), R1.2, R2.2

Notes on the sheet:
AWQUA
Temperature
Voltage
UART
Microprocessor
OLED Monitor
Daughter connectors

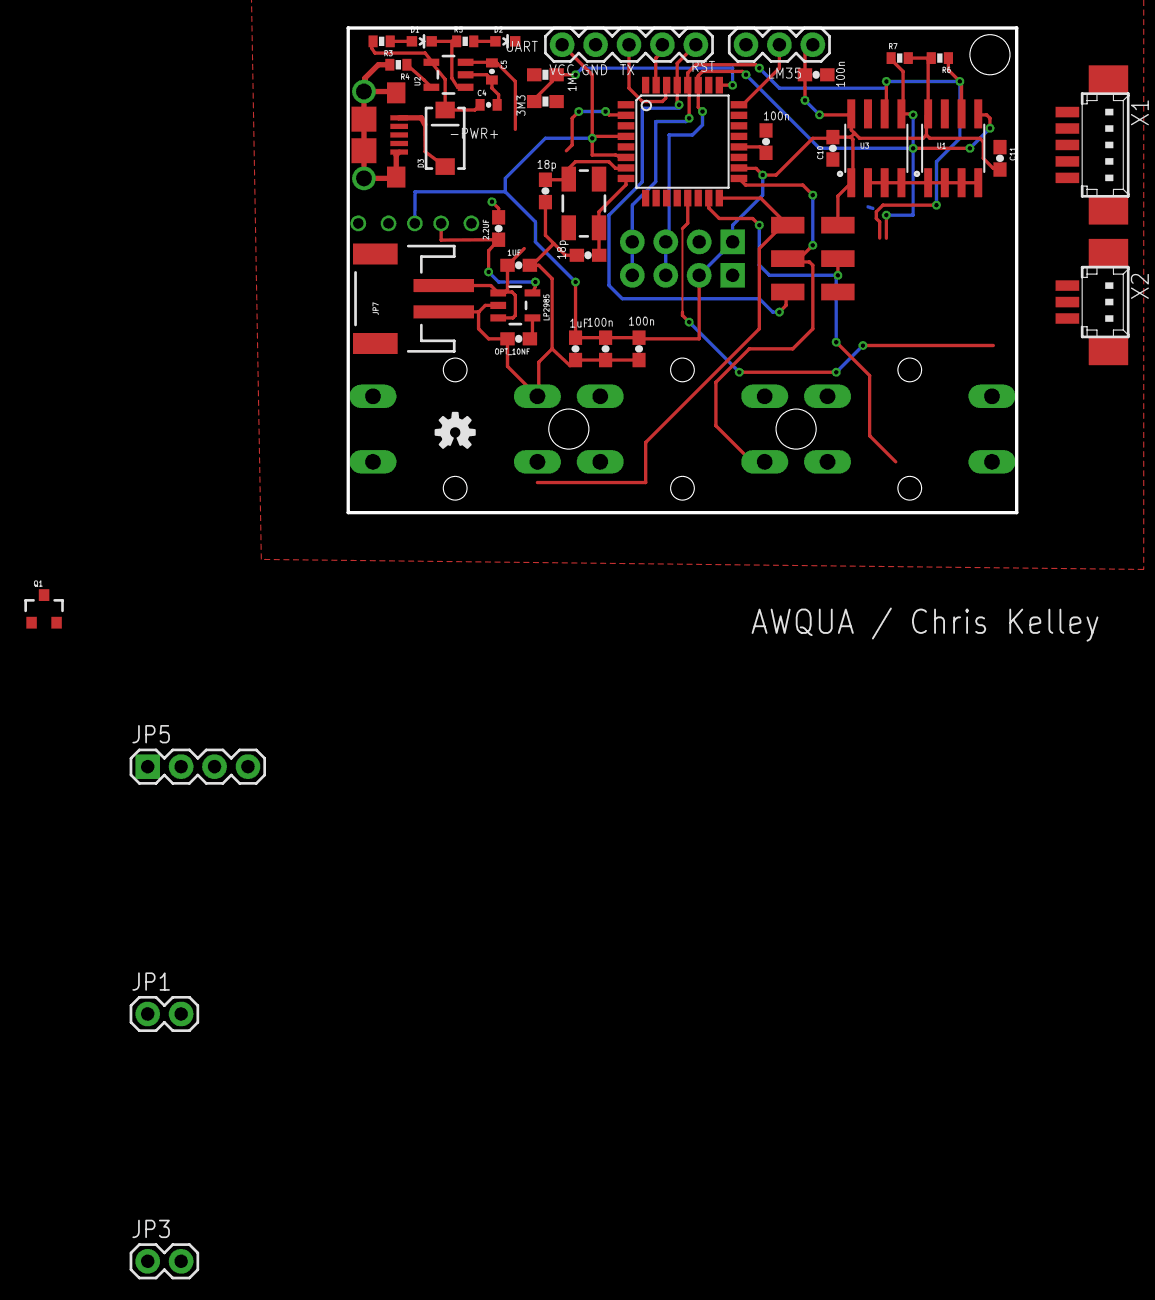
[picture p23: board main_board.brd from above]

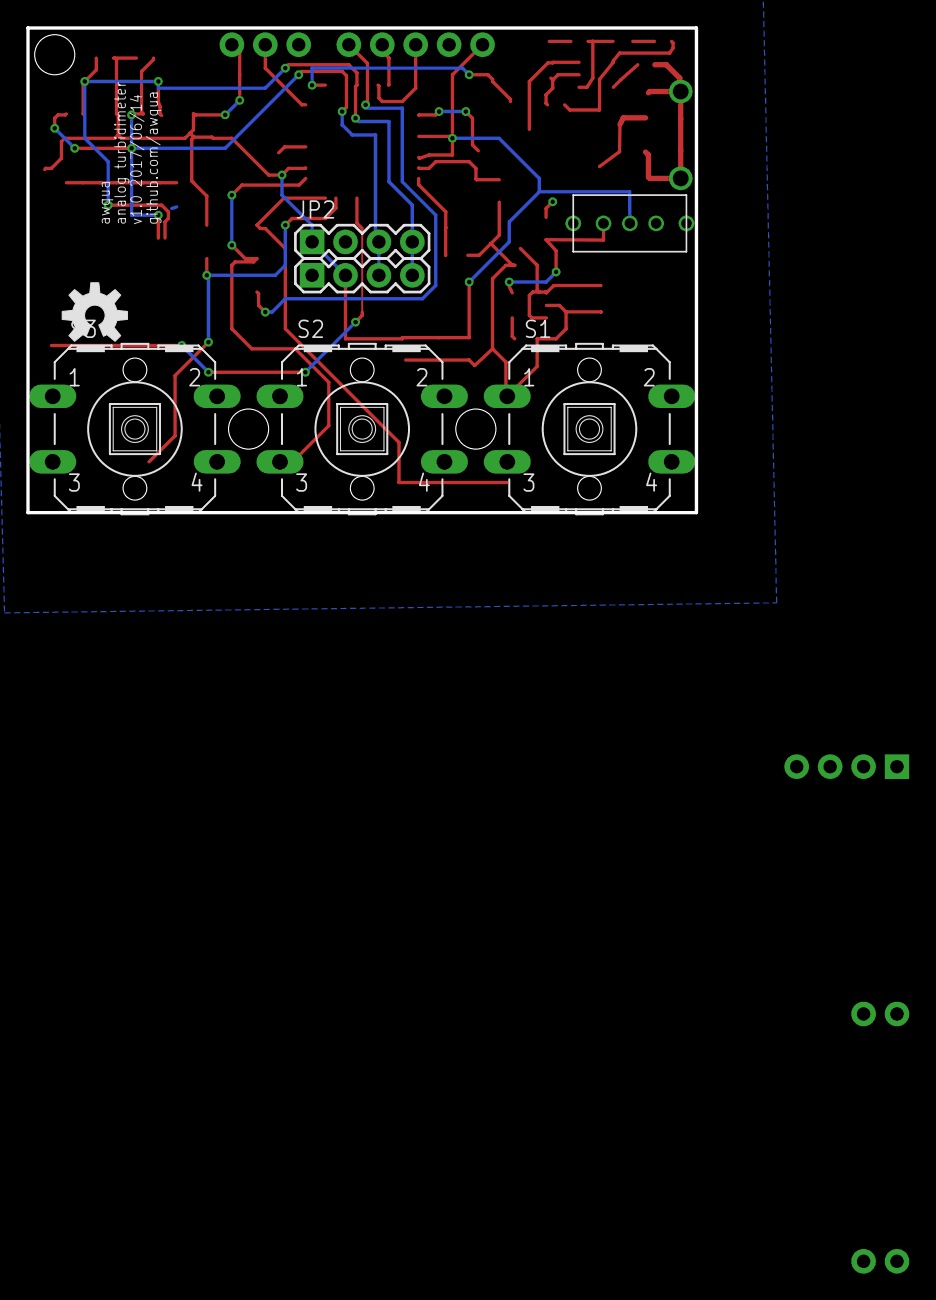
[picture p24: board main_board.brd from below]

Board: 2 copper layers, 50.8 x 36.8 mm, 50 parts (7 on the bottom side), 33 nets.

Other parts of the board:
U$4: OSHW-LOGO-M
U$5: OSHW-LOGO-S
