AWQUA/improved-handheld-turbidimeter/version_A/hardware/molex_breakout.brd

## EAGLE design version_A/hardware/molex_breakout.brd (2017-10-30, an earlier design)

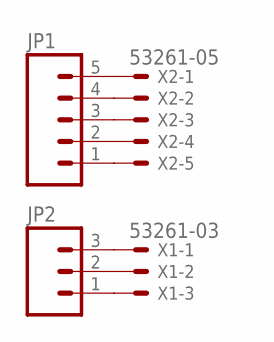
[picture p25: schematic molex_breakout.sch]

Parts:
JP1: M05PTH; 1X05
JP2: M03PTH; 1X03
X1: 53261-03
X2: 53261-05

Connections:
unnamed: JP2.3, X1.1
unnamed: JP2.2, X1.2
unnamed: JP2.1, X1.3
unnamed: JP1.5, X2.1
unnamed: JP1.4, X2.2
unnamed: JP1.3, X2.3
unnamed: JP1.2, X2.4
unnamed: JP1.1, X2.5

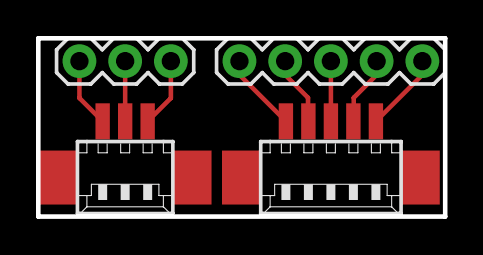
[picture p26: board molex_breakout.brd from above]

Board: 2 copper layers, 22.6 x 9.9 mm, 4 parts (0 on the bottom side), 8 nets.
