AWQUA/improved-handheld-turbidimeter/planning/hardware/IR_tester_light.brd

## EAGLE design planning/hardware/IR_tester_light.brd (2017-10-30)

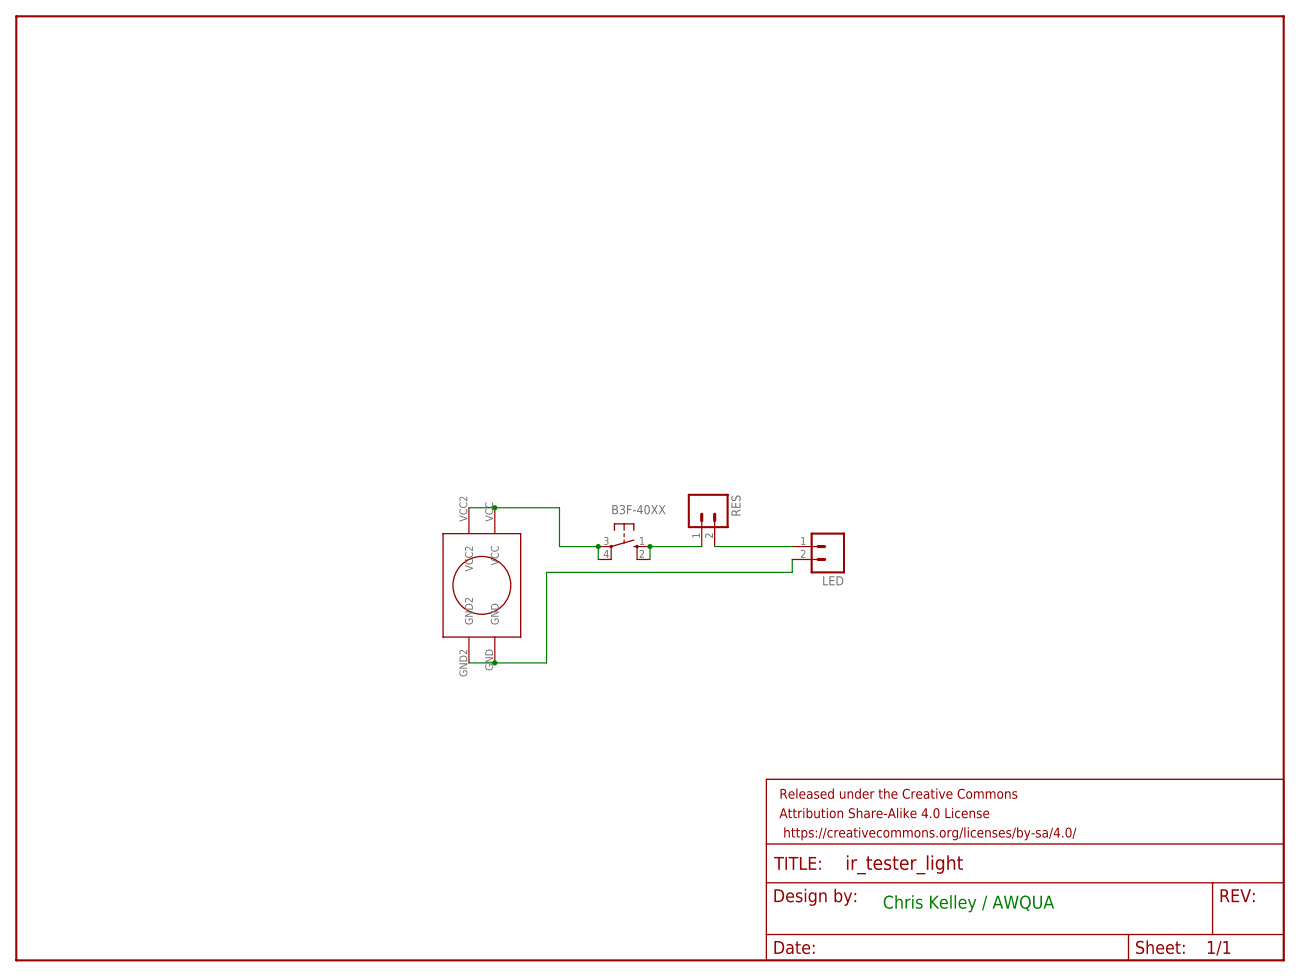
[picture p27: schematic IR_tester_light.sch]

Parts:
B3F-40XX: 40-XX; B3F-40XX
FRAME1: FRAME-LETTER; CREATIVE_COMMONS
LED: M02PTH; 1X02
RES: M02PTH; 1X02
U$1: CR1632-KEYSTYONE-3013

Connections:
GND: LED.2, U$1.GND, U$1.GND2
unnamed: LED.1, RES.2
unnamed: B3F-40XX.1 (S), B3F-40XX.2 (S1), RES.1
VCC: B3F-40XX.3, B3F-40XX.4 (P1), U$1.VCC, U$1.VCC2

Notes on the sheet:
Chris Kelley / AWQUA

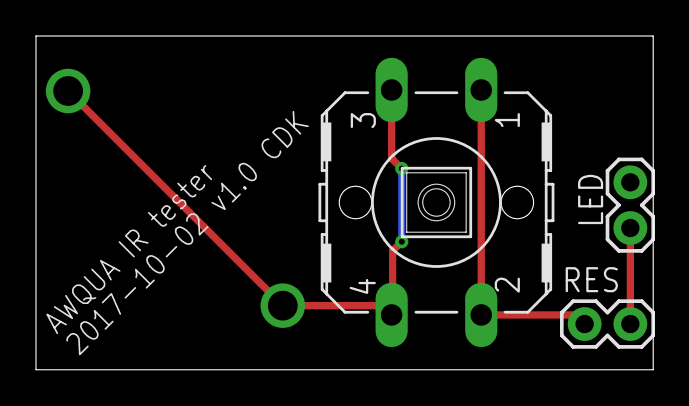
[picture p28: board IR_tester_light.brd from above]

Board: 2 copper layers, 34.3 x 18.5 mm, 5 parts (1 on the bottom side), 4 nets.
