AWQUA/improved-handheld-turbidimeter/planning/hardware/light_detector_ALR.brd

## EAGLE design planning/hardware/light_detector_ALR.brd (2017-10-30)

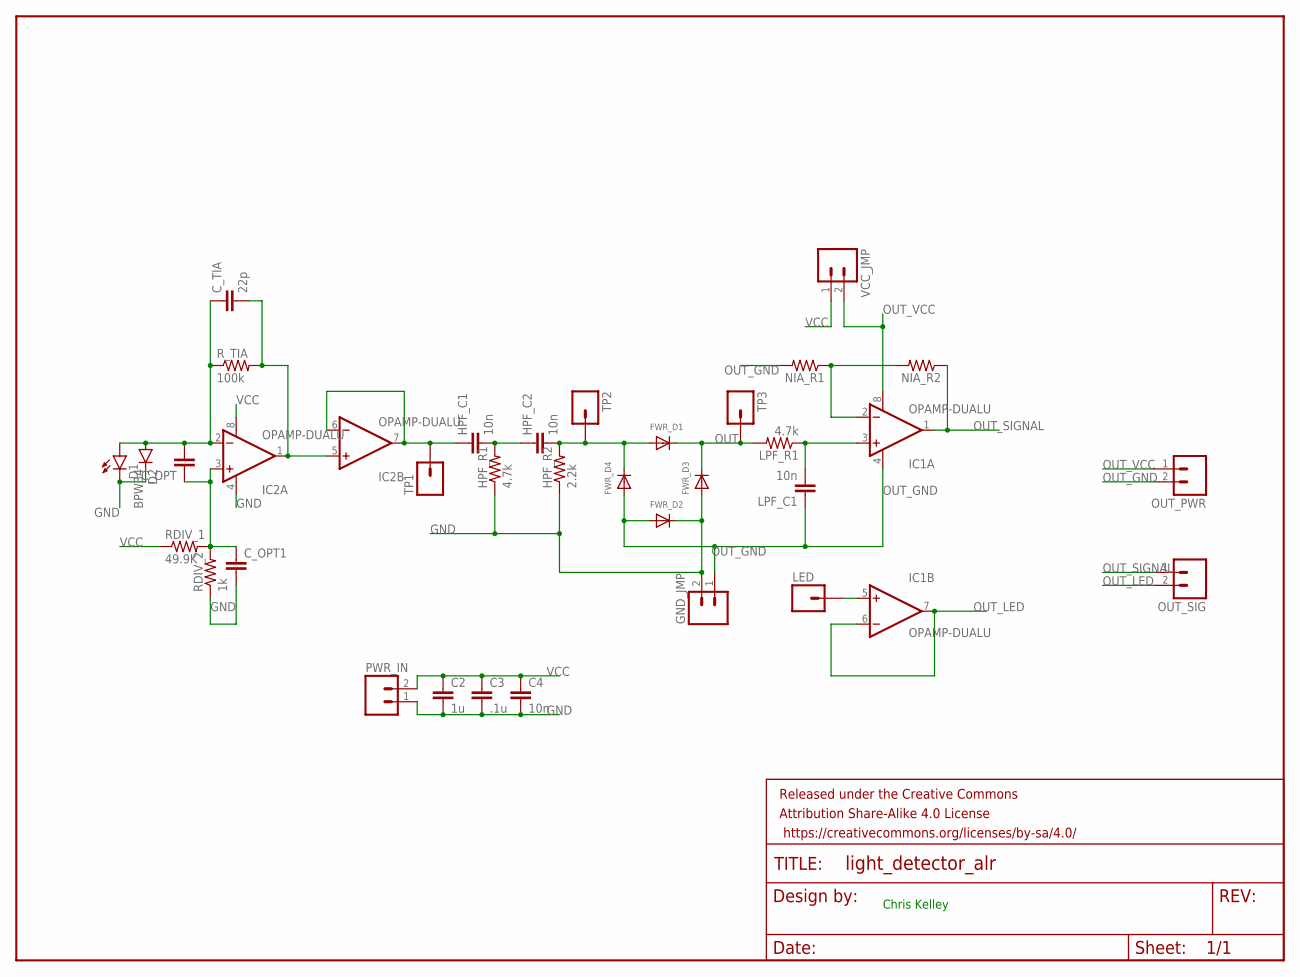
[picture p29: schematic light_detector_ALR.sch]

Parts:
C2: 1u; 0805
C3: .1u; 0805
C4: 10n; 0805
C_OPT, C_OPT1: CAP0805; 0805
C_TIA: 22p; 0805
D1: LED5MM
D2: BPW34
FRAME1: FRAME-LETTER; CREATIVE_COMMONS
FWR_D1, FWR_D2, FWR_D3, FWR_D4: DIODESOD-123; SOD-123
GND_JMP: M02PTH; 1X02
HPF_C1, HPF_C2: 10n; 0805
HPF_R1: 4.7k; 0603-RES
HPF_R2: 2.2k; 0603-RES
IC1, IC2: OPAMP-DUALU; SO08
LED: M01PTH; 1X01
LPF_C1: 10n; 0805
LPF_R1: 4.7k; 0603-RES
NIA_R1, NIA_R2: RESISTOR0603-RES; 0603-RES
OUT_PWR: M02PTH; 1X02
OUT_SIG: M02PTH; 1X02
PWR_IN: M02PTH; 1X02
RDIV_1: 49.9K; 0603-RES
RDIV_2: 1k; 0603-RES
R_TIA: 100k; 0603-RES
TP1, TP2, TP3: M01PTH; 1X01
VCC_JMP: M02PTH; 1X02

Connections:
GND: C2.2, C3.2, C4.2, C_OPT1.2, D1.K (C), D2.P$2 (C), FWR_D2.C, FWR_D3.A, GND_JMP.2, HPF_R1.1, HPF_R2.1, IC2.4 (V-), PWR_IN.1, RDIV_2.1
unnamed: C_OPT.2, C_TIA.1, D1.A, D2.P$1 (A), IC2.2 (-IN), R_TIA.1
unnamed: C_TIA.2, IC2.1 (OUT), IC2.5 (+IN), R_TIA.2
unnamed: C_OPT.1, C_OPT1.1, IC2.3 (+IN), RDIV_1.2, RDIV_2.2
unnamed: HPF_C1.2, HPF_C2.1, HPF_R1.2
unnamed: HPF_C1.1, IC2.6 (-IN), IC2.7 (OUT), TP1.1
unnamed: FWR_D1.A, FWR_D4.C, HPF_C2.2, HPF_R2.2, TP2.1
unnamed: IC1.3 (+IN), LPF_C1.2, LPF_R1.1
unnamed: IC1.2 (-IN), NIA_R1.1, NIA_R2.2
unnamed: IC1.5 (+IN), LED.1
OUT: FWR_D1.C, FWR_D3.C, LPF_R1.2, TP3.1
OUT_GND: FWR_D2.A, FWR_D4.A, GND_JMP.1, IC1.4 (V-), LPF_C1.1, NIA_R1.2, OUT_PWR.2
OUT_LED: IC1.6 (-IN), IC1.7 (OUT), OUT_SIG.2
OUT_SIGNAL: IC1.1 (OUT), NIA_R2.1, OUT_SIG.1
OUT_VCC: IC1.8 (V+), OUT_PWR.1, VCC_JMP.2
VCC: C2.1, C3.1, C4.1, IC2.8 (V+), PWR_IN.2, RDIV_1.1, VCC_JMP.1

Notes on the sheet:
Chris Kelley

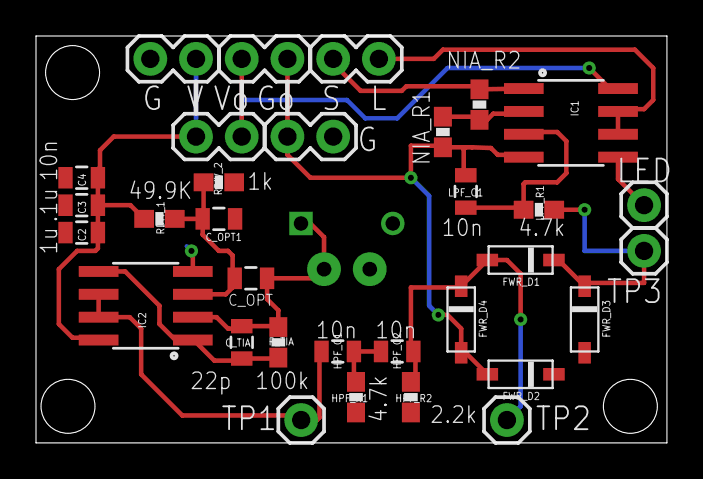
[picture p30: board light_detector_ALR.brd from above]

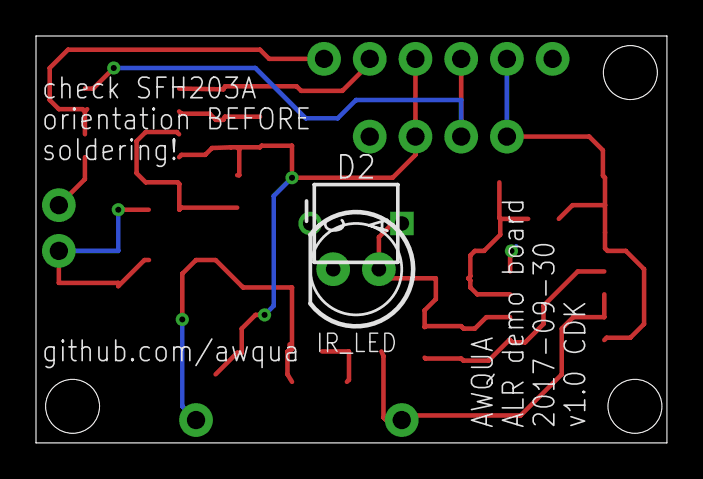
[picture p31: board light_detector_ALR.brd from below]

Board: 2 copper layers, 35.1 x 22.6 mm, 35 parts (2 on the bottom side), 16 nets.
