AWQUA/improved-handheld-turbidimeter/hardware/improved-handheld-turbidimeter_DAC_LED.brd

## EAGLE design hardware/improved-handheld-turbidimeter_DAC_LED.brd (2016-11-02)

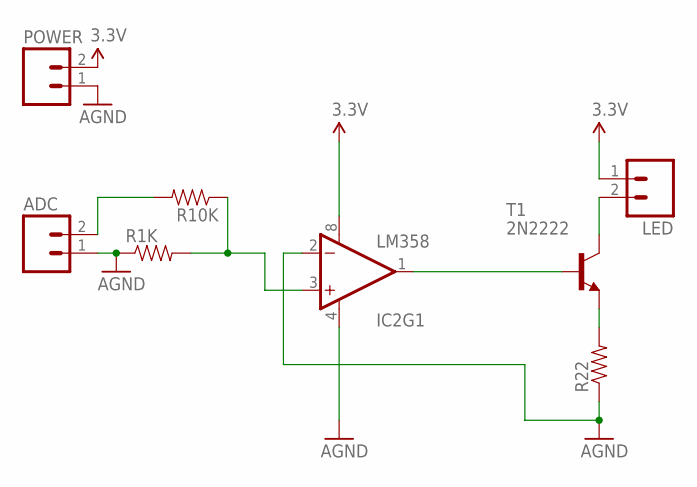
[picture p32: schematic improved-handheld-turbidimeter_DAC_LED.sch]

Parts:
ADC: M02PTH; 1X02
IC2: LM358; DIP08
LED: M02PTH; 1X02
POWER: M02PTH; 1X02
R1K, R10K, R22: RESISTOR0603-RES; 0603-RES
T1: 2N2222; TO92-EBC-OVAL

Connections:
3.3V: IC2.8 (V+), LED.1, POWER.2
AGND: ADC.1, IC2.2 (-IN), IC2.4 (V-), POWER.1, R1K.1, R22.1
unnamed: IC2.1 (OUT), T1.B
unnamed: LED.2, T1.C
unnamed: R22.2, T1.E
unnamed: ADC.2, R10K.2
unnamed: IC2.3 (+IN), R1K.2, R10K.1

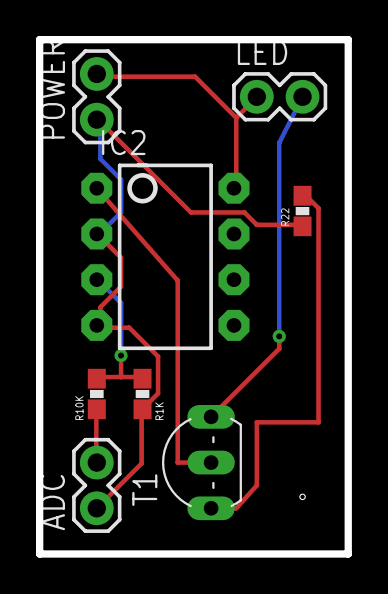
[picture p33: board improved-handheld-turbidimeter_DAC_LED.brd from above]

Board: 2 copper layers, 17.1 x 28.6 mm, 8 parts (0 on the bottom side), 7 nets.
