AWQUA/improved-handheld-turbidimeter/hardware/improved-handheld-turbidimeter_I2C.brd

## EAGLE design hardware/improved-handheld-turbidimeter_I2C.brd (2016-11-02)

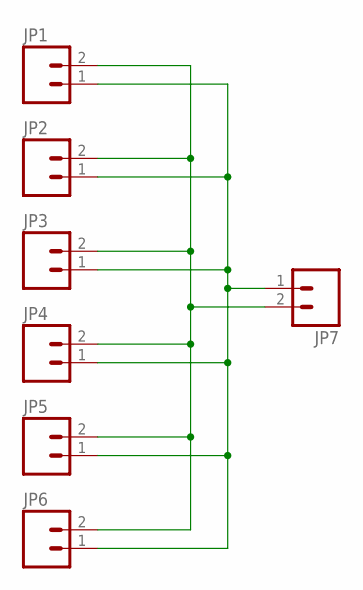
[picture p34: schematic improved-handheld-turbidimeter_I2C.sch]

Parts:
JP1, JP2, JP3, JP4, JP5, JP6, JP7: M02PTH; 1X02

Connections:
SCL: JP1.2, JP2.2, JP3.2, JP4.2, JP5.2, JP6.2, JP7.2
SDA: JP1.1, JP2.1, JP3.1, JP4.1, JP5.1, JP6.1, JP7.1

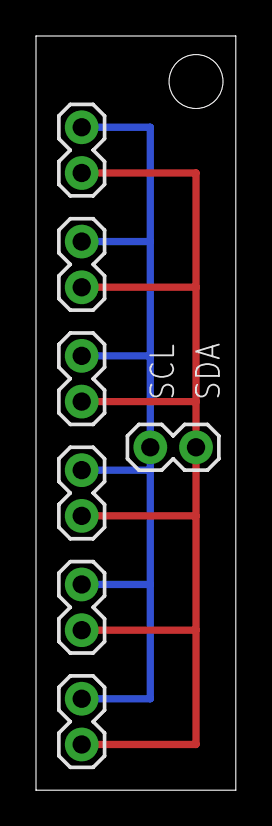
[picture p35: board improved-handheld-turbidimeter_I2C.brd from above]

Board: 2 copper layers, 11.1 x 41.9 mm, 7 parts (0 on the bottom side), 2 nets.
