AWQUA/improved-handheld-turbidimeter/hardware/improved-handheld-turbidimeter_power_decoupling.brd

## EAGLE design hardware/improved-handheld-turbidimeter_power_decoupling.brd (2016-11-02)

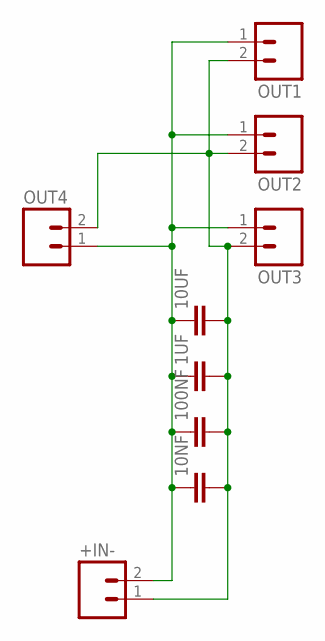
[picture p36: schematic improved-handheld-turbidimeter_power_decoupling.sch]

Parts:
1UF, 10NF, 10UF, 100NF: CAP0805; 0805
+IN-: M02PTH; 1X02
OUT1, OUT2, OUT3, OUT4: M02PTH; 1X02

Connections:
GND: 1UF.2, 10NF.2, 10UF.2, 100NF.2, +IN-.1, OUT1.2, OUT2.2, OUT3.2, OUT4.2
VCC: 1UF.1, 10NF.1, 10UF.1, 100NF.1, +IN-.2, OUT1.1, OUT2.1, OUT3.1, OUT4.1

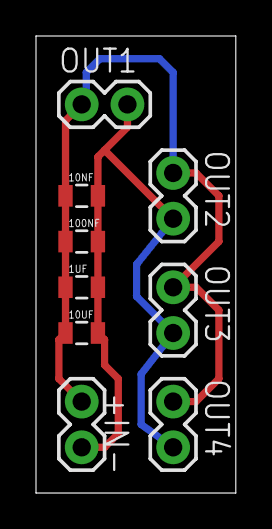
[picture p37: board improved-handheld-turbidimeter_power_decoupling.brd from above]

Board: 2 copper layers, 11.1 x 25.4 mm, 9 parts (0 on the bottom side), 2 nets.
