AWQUA/improved-handheld-turbidimeter/hardware/improved-handheld-turbidimeter_TIA.brd

## EAGLE design hardware/improved-handheld-turbidimeter_TIA.brd (2016-11-02)

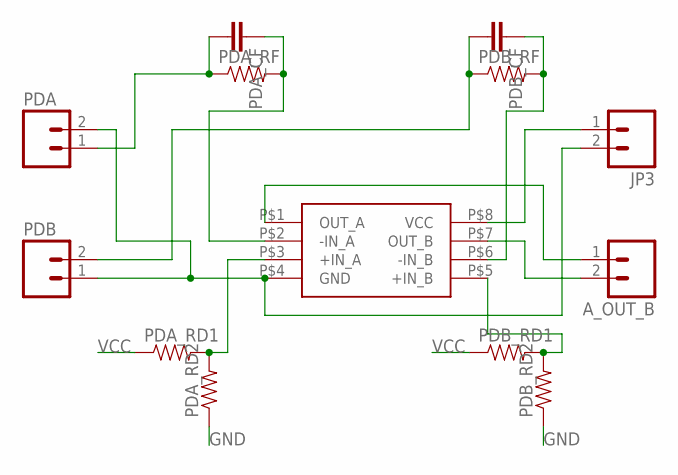
[picture p38: schematic improved-handheld-turbidimeter_TIA.sch]

Parts:
A_OUT_B: M02PTH; 1X02
JP3: M02PTH; 1X02
PDA: M02PTH; 1X02
PDA_CF: CAP0603-CAP; 0603-CAP
PDA_RD1, PDA_RD2: RESISTOR0603-RES; 0603-RES
PDA_RF: RESISTOR0603-RES; 0603-RES
PDB: M02PTH; 1X02
PDB_CF: CAP0603-CAP; 0603-CAP
PDB_RD1, PDB_RD2: RESISTOR0603-RES; 0603-RES
PDB_RF: RESISTOR0603-RES; 0603-RES
U$2: ADA4528-2

Connections:
GND: JP3.2, PDA.2, PDA_RD2.1, PDB.1, PDB_RD2.1, U$2.P$4 (GND)
unnamed: PDA.1, PDA_CF.2, PDA_RF.1
unnamed: PDA_CF.1, PDA_RF.2, U$2.P$2 (-IN_A)
unnamed: PDB.2, PDB_CF.2, PDB_RF.1
unnamed: PDB_CF.1, PDB_RF.2, U$2.P$6 (-IN_B)
unnamed: PDA_RD1.2, PDA_RD2.2, U$2.P$3 (+IN_A)
unnamed: PDB_RD1.2, PDB_RD2.2, U$2.P$5 (+IN_B)
OUTA: A_OUT_B.1, U$2.P$1 (OUT_A)
OUTB: A_OUT_B.2, U$2.P$7 (OUT_B)
VCC: JP3.1, PDA_RD1.1, PDB_RD1.1, U$2.P$8 (VCC)

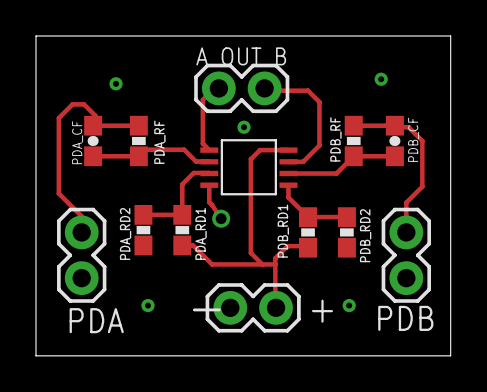
[picture p39: board improved-handheld-turbidimeter_TIA.brd from above]

Board: 2 copper layers, 23.0 x 17.8 mm, 13 parts (0 on the bottom side), 10 nets.
