AWQUA/improved-handheld-turbidimeter/version_B/hardware/main_board__INC.brd

## EAGLE design version_B/hardware/main_board__INC.brd (2017-10-30, an earlier design)

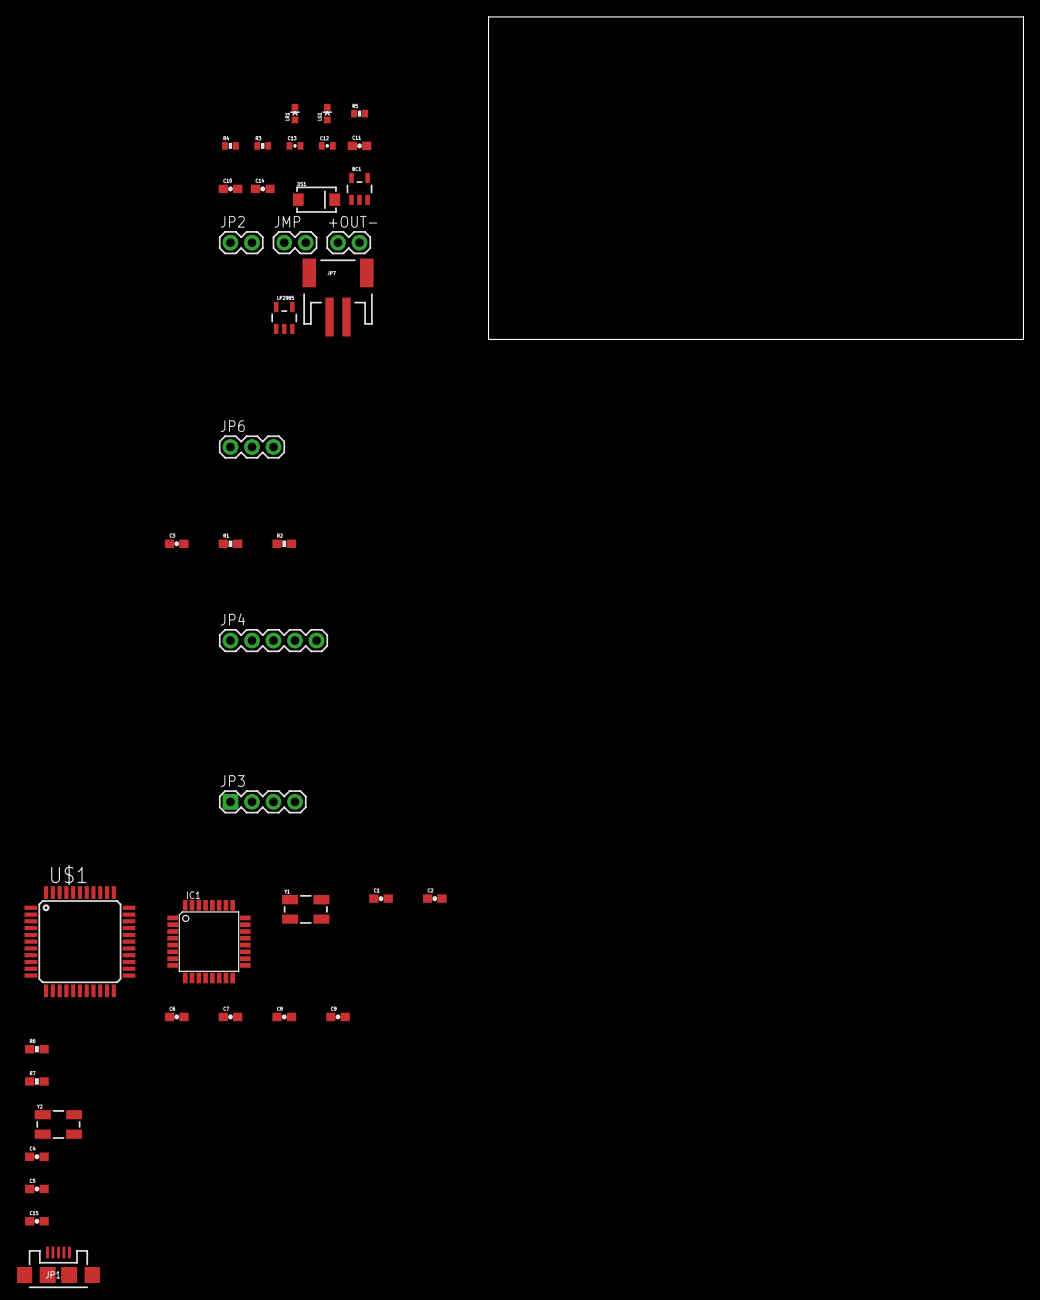
[picture p40: board main_board__INC.brd from above]

Board: 2 copper layers, 63.2 x 38.1 mm, 39 parts (0 on the bottom side), 29 nets, no tracks yet.

Parts:
+OUT-: 1X02
BC1: MCP73831; SOT23-5
C1, C2, C4, C5: 18p; 0603-CAP
C3, C6, C7, C8, C15: 100n; 0603-CAP
C9, C10: 1uF; 0603-CAP
C11: 2.2uF; 0603-CAP
C12, C13: 4.7uF; 0402-CAP
C14: 10nF (OPT); 0603-CAP
DS1: MBRA140; SMA-DIODE
IC1: MEGA8-AI; TQFP32-08
JMP: 1X02
JP1: USB-MICROB
JP2: 1X02
JP3: 1X04
JP4: 1X05
JP6: 1X03
JP7: LiPo Battery; JST-2-SMD
LG1: GREEN; LED-0603
LR1: RED; LED-0603
R1: 33.2k; 0603-RES
R2: 14k; 0603-RES
R3: 2K; 0402-RES
R4, R5: 330; 0402-RES
R6, R7: 22; 0603-RES
U$1: ATMEGA32U4-AU; TQFP44
VR1: LP2985
Y1, Y2: CRYSTAL-SMD-5X3

Connections:
AREF: C7.1, IC1.20
BTN1: IC1.2, JP3.4
BTN2: IC1.9, JP3.3
BTN3: IC1.10, JP3.2
D+: JP1.D+, R7.2
D-: JP1.D-, R6.2
GND: +OUT-.2, BC1.2, C1.1, C2.1, C3.1, C4.1, C5.1, C6.2, C7.2, C8.2, C9.2, C10.2, C11.2, C12.2, C13.2, C14.2, C15.2, IC1.3, IC1.5, IC1.21, JMP.1, JP1.GND, JP1.MT1, JP1.MT2, JP2.1, JP3.1, JP4.2, JP6.1, JP7.1, LG1.C, R2.1, R3.2, U$1.15, U$1.23, U$1.35, U$1.43, VR1.2
unnamed: C14.1, VR1.4
unnamed: LG1.A, R5.2
unnamed: LR1.A, R4.1
unnamed: +OUT-.1, C11.1, VR1.5
unnamed: DS1.A, JP2.2
unnamed: R6.1, U$1.3
unnamed: R7.1, U$1.4
unnamed: C15.1, U$1.42
unnamed: C4.2, U$1.17, Y2.3
unnamed: C5.2, U$1.16, Y2.1
PROG: BC1.5, R3.1
Q1: C2.2, IC1.8, Y1.1
Q2: C1.2, IC1.7, Y1.3
RST: IC1.29, JP4.5
RX: IC1.30, JP4.3
STAT: BC1.1, LR1.C, R5.1
TEMP: IC1.24, JP6.2
TX: IC1.31, JP4.4
VBUS: JP1.VBUS, U$1.7
VCC: BC1.3, C3.2, C6.1, C8.1, C9.1, C10.1, C13.1, IC1.4, IC1.6, IC1.18, JMP.2, JP4.1, JP6.3, JP7.2, R1.1, VR1.1, VR1.3
VIN: BC1.4, C12.1, DS1.C, R4.2
VOLT: IC1.25, R1.2, R2.2
