AWQUA/improved-handheld-turbidimeter/(commit log)

2016-08-13 beginning migration from breadboard
    [improved-handheld-turbidimeter_TIA.brd, improved-handheld-turbidimeter_TIA.sch]
2016-08-24 basic TIA board routed
    [improved-handheld-turbidimeter_TIA.brd, improved-handheld-turbidimeter_TIA.sch]
2016-11-02 updates to TIA
    [improved-handheld-turbidimeter_TIA.brd]
2016-11-02 new and updated component boards
    [improved-handheld-turbidimeter_DAC_LED.brd, improved-handheld-turbidimeter_DAC_LED.sch, improved-handheld-turbidimeter_I2C.brd, improved-handheld-turbidimeter_I2C.sch, improved-handheld-turbidimeter_controls_monitor.brd, improved-handheld-turbidimeter_controls_monitor.sch, improved-handheld-turbidimeter_power_decoupling.brd, improved-handheld-turbidimeter_power_decoupling.sch]
2017-01-15 hardware update
    [improved-handheld-turbidimeter_DAC_LED.sch]
2017-10-30 updates from local
    [BT_magnetic_switch.brd, BT_magnetic_switch.sch, DAC_LED__TH.brd, DAC_LED__TH.sch, I2C.brd, I2C.sch, IR_tester_light.brd, IR_tester_light.sch]
2017-10-31 stencil files added for ALR demo board
